bradfourie/edesign_344/README.md

# E344
I Bradley Fourie, student number 20795629 I declare
that the entirety of the work contained here is my own work towards completing E344 at Stellenbosch
Univeristy, and that I am the sole author thereof. I understand that copying someone else’s work is
theft, and that doing so may lead to disciplanary action against me.
