bradfourie/edesign_344/Reports/Fourie_20795629_A3/App-A.tex

     \chapter{Appendix A: GitHub activity heatmap}

     \begin{figure}[!htb]
     \centering
     	\fbox{}
	\label{fig:github}
	\end{figure}
