bradfourie/edesign_344/Reports/Fourie_20795629_A3/App-D.tex

\chapter{Appendix D: Signal conditioning calibration}

\begin{table} [h!]
        \centering
        \footnotesize
        \caption{Voltage transducer calibration results.}
             \begin{tabular}{C{2cm} C{2cm} C{2cm} C{2cm} }
           Emulated level & Applied input & Analogue output & Deduced input  \\
           ($V_{peak}$)   & ($V_{peak}$)   & ($V_{peak}$)   & ($V_{peak}$)        \\
           \hline
            10      & 1.34 & 1.33 & 9.95 \\
            15      & 2.06 & 2.00 & 14.62 \\
            20      & 2.77 & 2.69 & 19.41 \\
            25      & 3.49 & 3.37 & 24.15 \\
            30      & 4.21 & 4.05 & 28.88\\
          \hline
        \end{tabular}
     \label{tab:voltagetransducercalibrated}
\end{table}

\begin{table} [h!]
        \centering
        \footnotesize
        \caption{Current transducer calibration results.}
           \begin{tabular}{C{2cm} C{2cm} C{2cm} C{2cm} }
            Emulated level     & Applied input & Analogue output & Deduced input  \\
            ($mA_{peak}$) & ($V_{peak}$)   & ($V_{peak}$)   & ($mA_{peak}$)       \\
           \hline
             5.33  & 0.108 & 0.099 & 7.59 \\
             9.09  & 0.146 & 0.202 & 10.26 \\
             16.67 & 0.242 & 0.202 & 14.20 \\
             29.89 & 0.425 & 0.396 & 27.84\\
          \hline
        \end{tabular}
     \label{tab:currenttransducercalibrated}
\end{table}

\begin{table} [h!]
        \centering
        \scriptsize
        \caption{Phase shift transducer calibration results.}
            \begin{tabular}{C{2cm} C{2cm} C{2cm} C{2cm} }
            Emulated level     & Applied input & Analogue output & Deduced input  \\
            ($^o$)       & ($V_{peak}$)   & ($V_{peak}$)     & ($^o$) \\
            \hline
            0        & 0      & 0.072 & 2.592 \\
            6.48     & 0.180  & 0.240 & 8.62 \\
            26.88    & 1.08   & 0.832 & 29.83 \\
          \hline
        \end{tabular}
     \label{tab:phasetransducercalibrated}
\end{table}
