bradfourie/edesign_344/Reports/Fourie_20795629_A3/App-E.tex

\chapter{Appendix D: System schematic}

\begin{figure}[h]
  \centering
 \footnotesize
        
    		    \caption{Full system schematic.} \label{fig:full_circuit_diagram}
 \end{figure}
