bradfourie/edesign_344/Reports/Fourie_20795629_A3/E344Ass3Template.pdf

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

# Declaration

By submitting this report electronically, I declare that the entirety of the work contained therein is my own, original work, that I am the sole author thereof (save to the extent explicitly otherwise stated), that reproduction and publication thereof by Stellenbosch University will not infringe any third party rights and that I have not previously in its entirety or in part submitted it for obtaining any qualifcation.

**** Put your signature here and remove this line ****

Signature: |
E. Stewdent
Date: |

i

# Contents

Declaration | i
Contents | ii
List of Figures | iv
List of Tables | v
Nomenclature | vi
1 System design | 1
2 Power conversion | 2
3 Signal conditioning | 6
4 Over-current protection | 12

ii

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

# List of Figures

1.1 | System diagram | | 1
2.1 | Power conversion circuit diagram | | 2
2.2 | I am the short caption that appears in the List of Figures | | 4
2.3 | Implementation of the power conversion circuitry | | 5
3.1 | Voltage transducer circuit diagram | | 6
3.2 | Voltage transducer results. (a) No load simulated. (b) No load measured.
| (c) Mid-sized load simulated. (d) Mid-sized load measured. (c) | | 7
3.3 | Current transducer circuit diagram | | 8
3.4 | Current transducer results. (a) No load simulated. (b) No load measured.
| (c) Mid-sized load simulated. (d) Mid-sized load measured. (c) | | 9
3.5 | Phase-shift transducer circuit diagram | 10
3.6 | Phase-shift transducer results. (a) Resistive load simulated. (b) Resistive
| load measured. (c) Mid-sized capacitive load simulated. (d) Mid-sized ca-
pacitive load measured. (c) | 11
3.7 | Implementation of the transducers circuitry | 11
7.1 | Complete PCB | 15

iv

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

# Chapter 1

# System design

## 1.1 System overview

Here you insert a block diagram of your operational signal conditioning system. Try to explain what congiation you chose and why. There is no need to specify the capacitor and resistor values here, but you want to capture the higher-level functional arrangement you have opted for. The diagram ties together the other chapters in this report and helps the reader understand how you have connected the dierent funtional blocks together to produce the outputs. For example, a block could be Dierential aplier or level shifting op-amps or the like. Fig. 1.1 as an example that is completely irrelevant and just holds space for your beautiful system diagram.

18 VAC

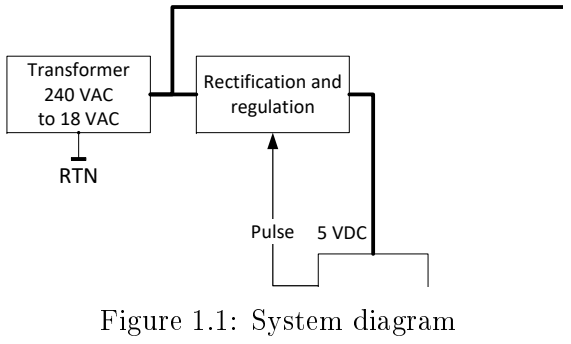
[picture p34: figure]
Rectification and regulation; Transformer 240 VAC to 18 VAC; Pulse; 5 VDC; RTN; Figure 1.1: System diagram

1

# Chapter 2

# Power conversion

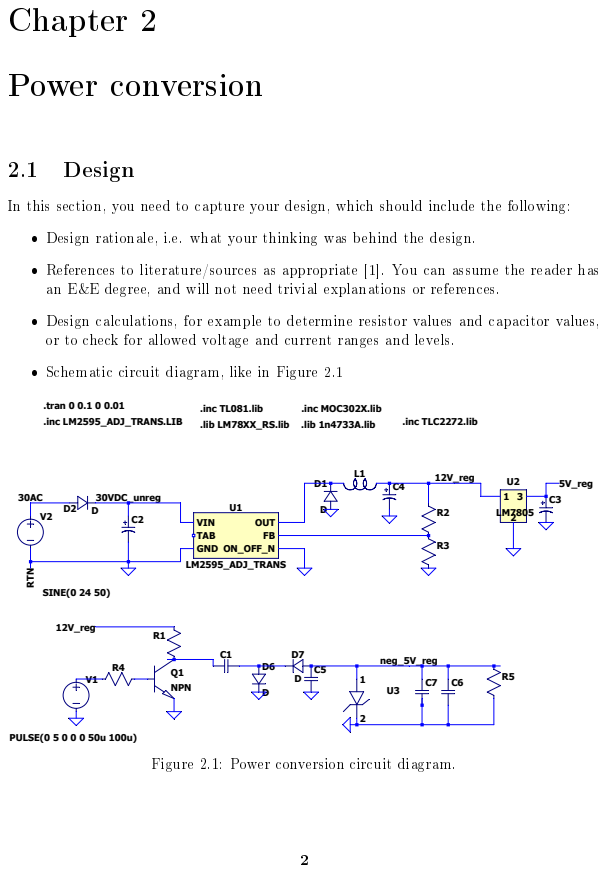
[picture p35: page 9]

In this section, you need to capture your design, which should include the following:

an E&E degree, and will not need trivial explanations or references.

or to check for allowed voltage and current ranges and levels.

.lib LM78XX_RS.lib .lib 1n4733A.lib

Figure 2.1: Power conversion circuit diagram.

CHAPTER 2. POWER CONVERSION | 3

## 2.2 Simulation

In this section, you want to demonstrate, by means of referring to simulation results, using the designed circuit, how your circuit is expected to behave. Present and report on your simulated results in Figures 2.2a, 2.2c and 2.2e Be absolutely sure that the text and information in your report are readable.

## 2.3 Measurements

In this secion, you must present and report on your measured results similar to Figures 2.2b, 2.2d and 2.2f - you can use a photo or screenshot of the scope, as long as I can zoom in to see the necessary detail.

## 2.4 Summary and implementation

State whether your design performs as expected. Give a snapshot of the relevant part of your circuit in Figure 2.3.

CHAPTER 2. POWER CONVERSION | 4

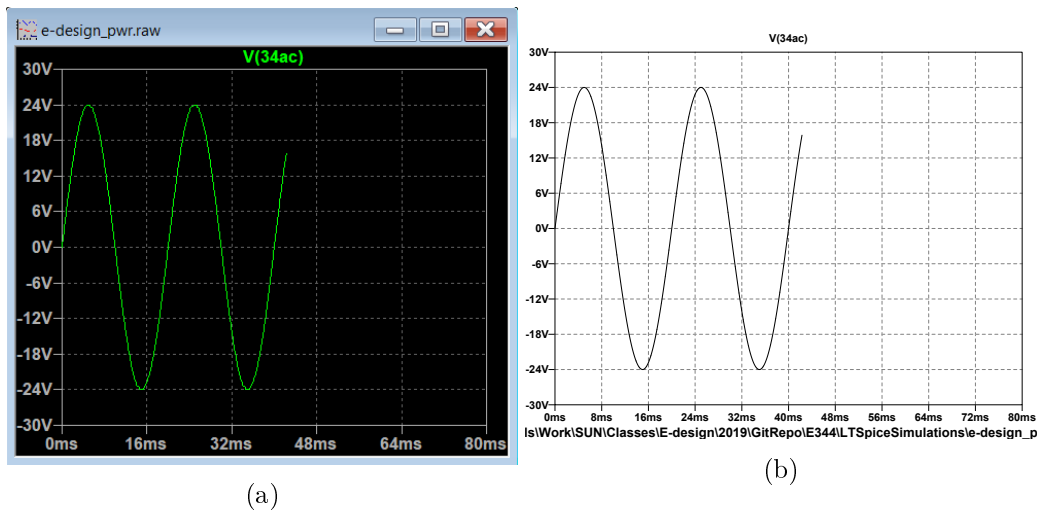
[picture p36: figure]
ls\Work\SUN\Classes\E-design\2019\GitRepo\E344\LTSpiceSimulations\e-design_p (b)
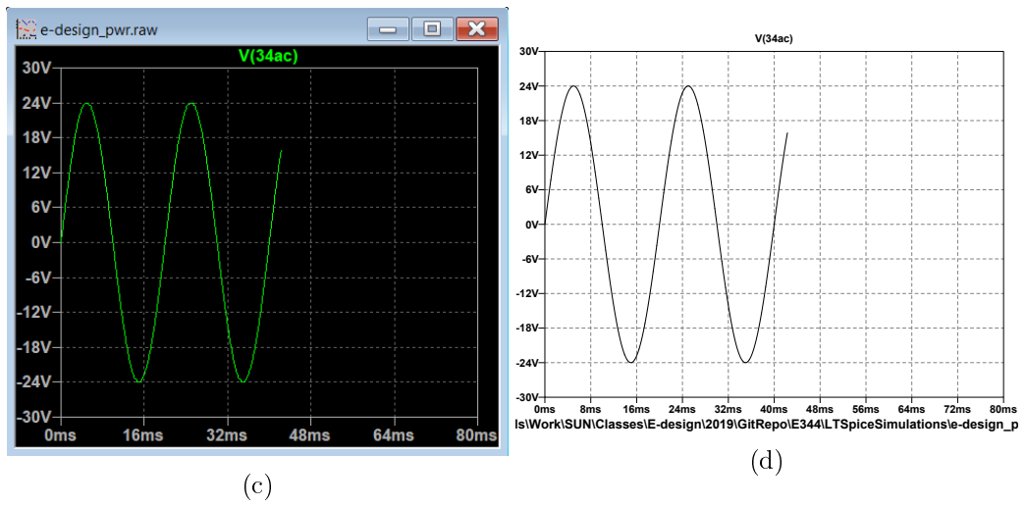
[picture p37: figure]
ls\Work\SUN\Classes\E-design\2019\GitRepo\E344\LTSpiceSimulations\e-design_p (d)
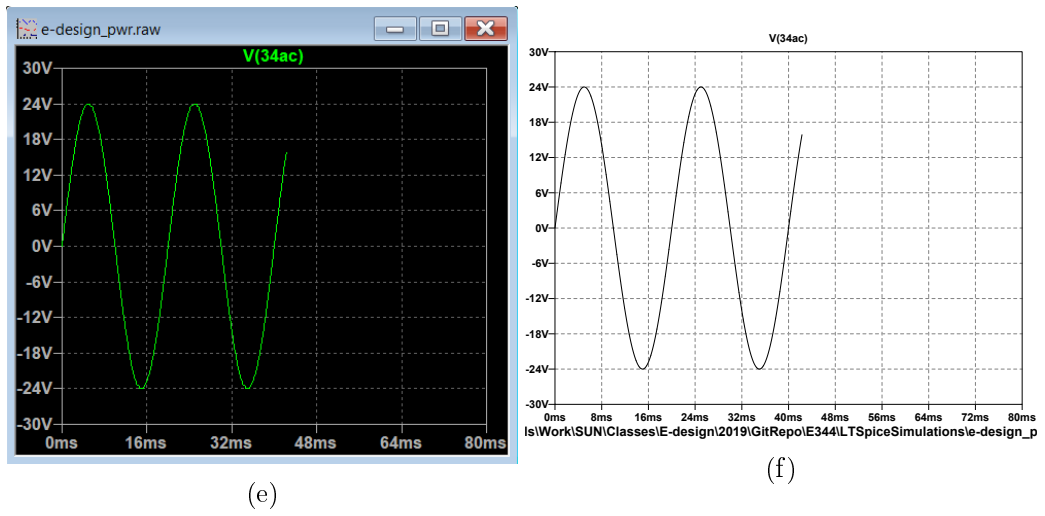
[picture p38: figure]
ls\Work\SUN\Classes\E-design\2019\GitRepo\E344\LTSpiceSimulations\e-design_p (f)

Figure 2.2: Power conditioning: (a) Simulation of the rectication showing the input AC and the rectied signal. (b) Measurement of the rectication showing the input AC and the rectied signal. (c) Simualtion output of the voltage rail levels. (d) Measurement of the output voltage rails levels. (e) Simulation output of the noise on the voltage rails. (f) Measurement of the noise on the voltage rails.

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

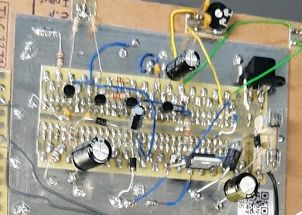
[picture p39: figure]

# Chapter 3

# Signal conditioning

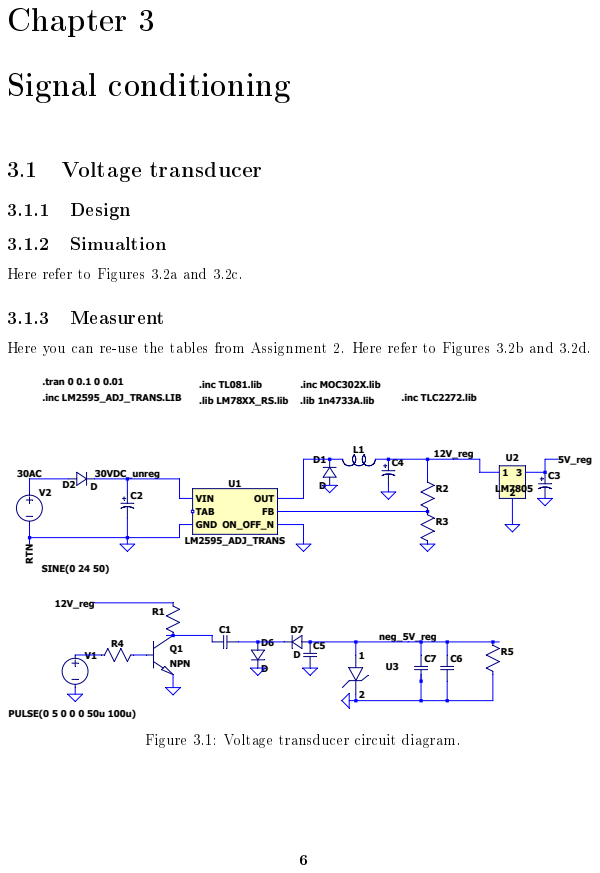
[picture p40: page 13]

Here refer to Figures 3.2a and 3.2c.

Here you can re-use the tables from Assignment 2. Here refer to Figures 3.2b and 3.2d.

.lib LM78XX_RS.lib .lib 1n4733A.lib

Figure 3.1: Voltage transducer circuit diagram.

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

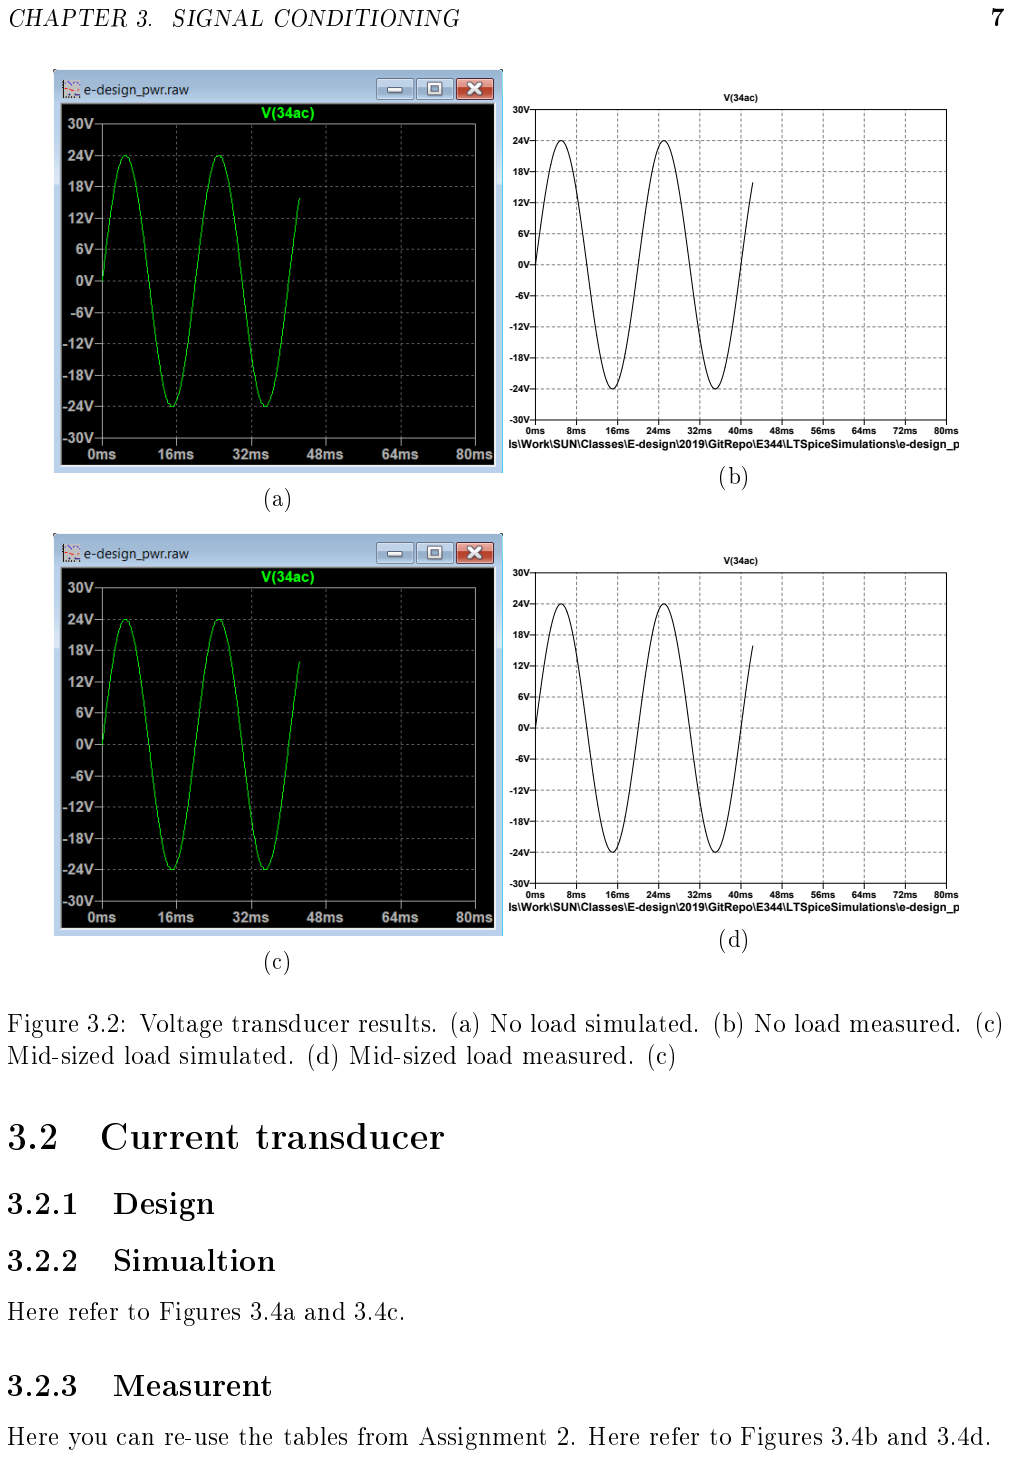
[picture p41: page 14]

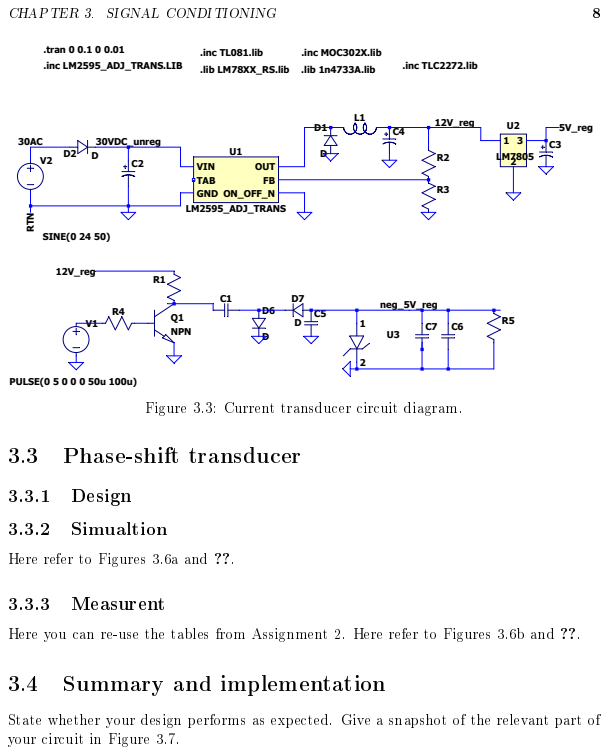
[picture p42: page 15]

.lib LM78XX_RS.lib .lib 1n4733A.lib

Figure 3.3: Current transducer circuit diagram.

Here refer to Figures 3.6a and ??.

Here you can re-use the tables from Assignment 2. Here refer to Figures 3.6b and ??.

State whether your design performs as expected. Give a snapshot of the relevant part of
your circuit in Figure 3.7.

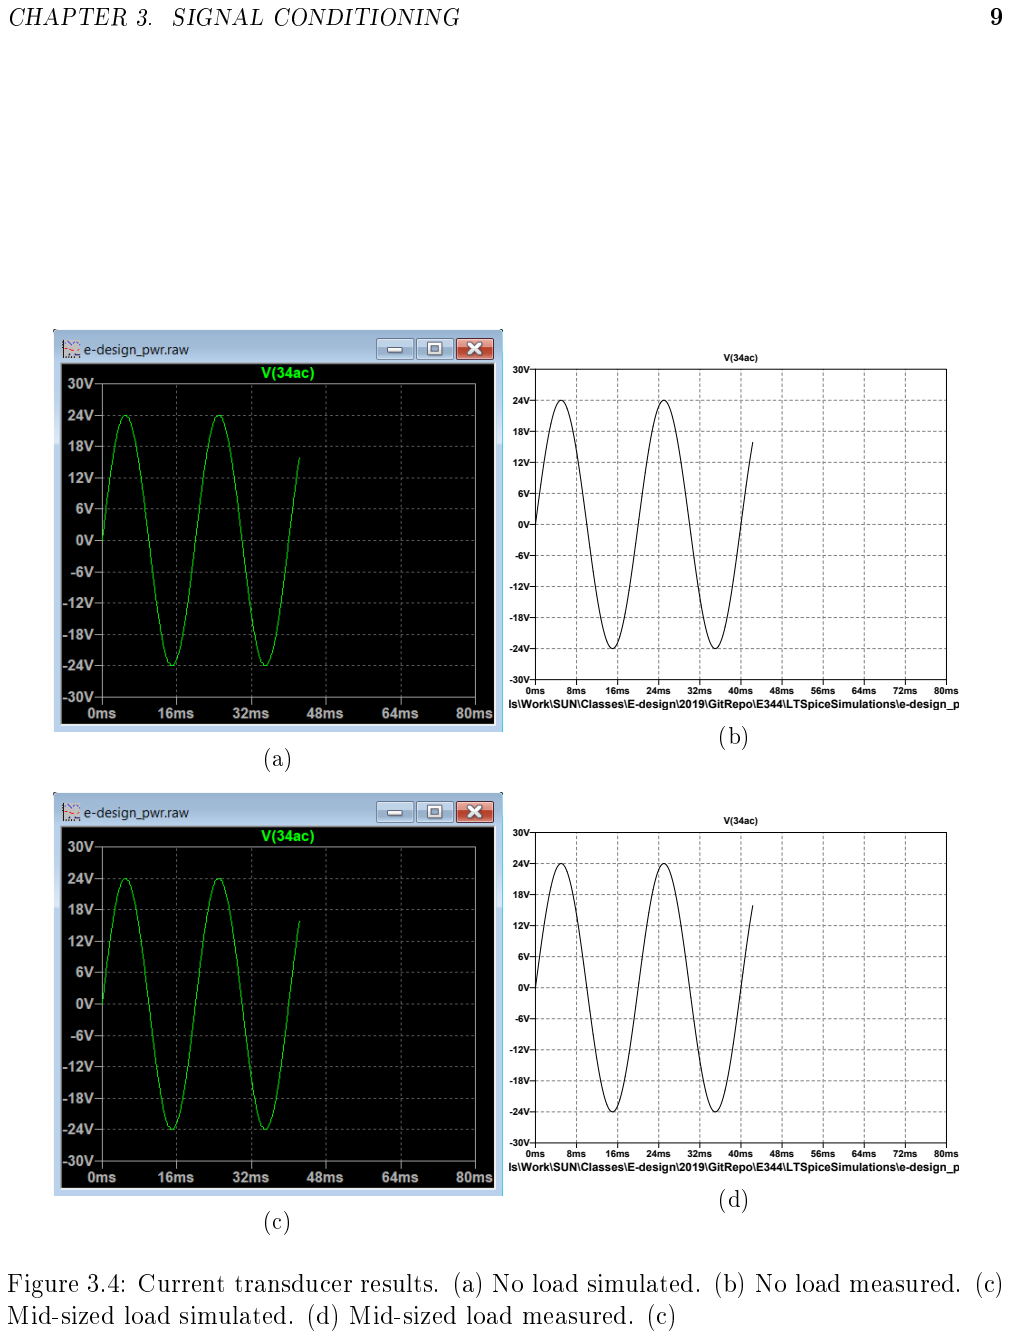
[picture p43: page 16]
CHAPTER 3. SIGNAL CONDITIONING

ls\Work\SUN\Classes\E-design\2019\GitRepo\E344\LTSpiceSimulations\e-design_p

Figure 3.4: Current transducer results. (a) No load simulated. (b) No load measured. (c)
Mid-sized load simulated. (d) Mid-sized load measured. (c)

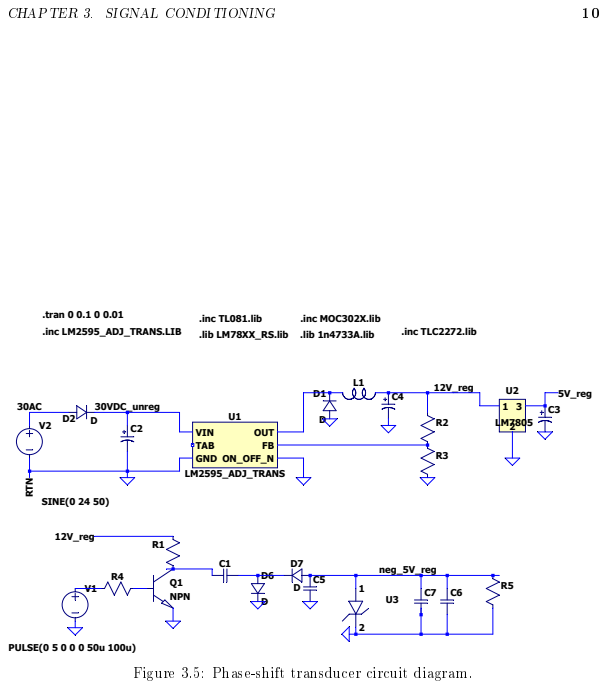
[picture p44: page 17]

.lib LM78XX_RS.lib .lib 1n4733A.lib

Figure 3.5: Phase-shift transducer circuit diagram.

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

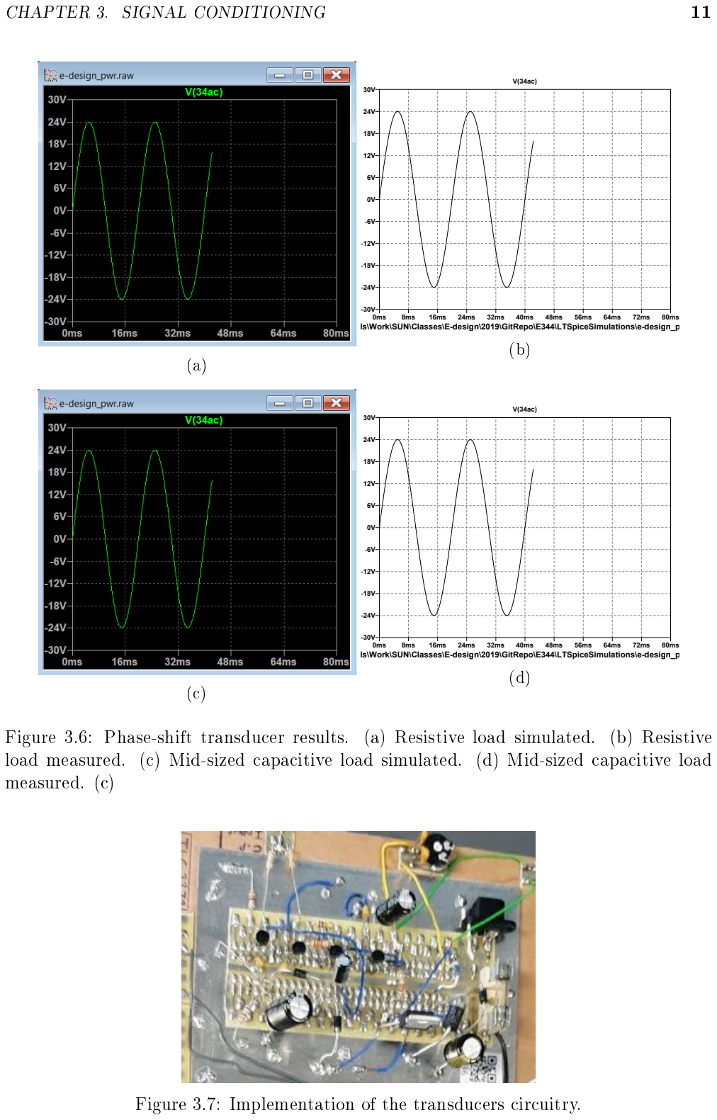
[picture p45: page 18]

# Chapter 4

# Over-current protection

Follow the same format as the previous chapters - circuit diagram, and then simulated and measured results.

## 4.1 Design

## 4.2 Simulation

## 4.3 Measurements

12

# Chapter 5

# Reporting

## 5.1 Design

Here give a ow diagram or psuedocode listing of your Arduino code and a ow diagram or psuedocode of your Python code. Give a circuit diagram and/or description of how you connected the grounds vs voltages and how you protected the interface to the Beetle agains over-voltage conditions. Maybe show a screengrab of the scope measuring the UART line.

## 5.2 Results

Show some screen grabs of your GUI.

13

# Chapter 6

# Extra functionality

Be very clear about what the extra functionality is, and convince the reader.

14

# Chapter 7

# System and conclusion

## 7.1 System

Photo of your student card next to your PCB. Indicate the functional blocks of your PBC here (preferably by overlaying blocks using something like powerpoint.

## 7.2 Lessons learned

Write down at least ve of the most important things you have learned or lessons you acquired from E344.

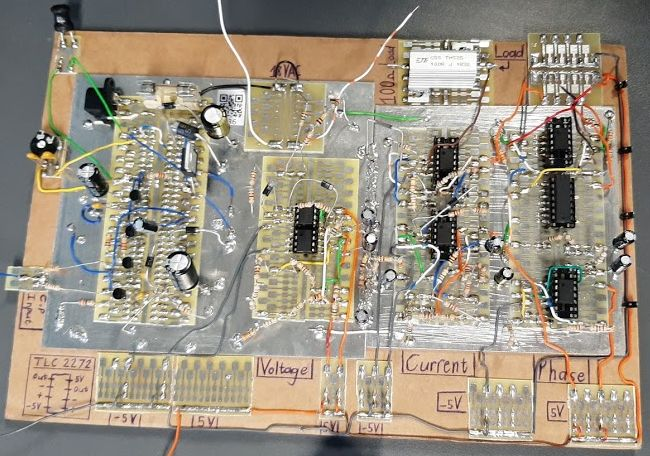
[picture p46: figure]

Figure 7.1: Complete PCB.

15

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

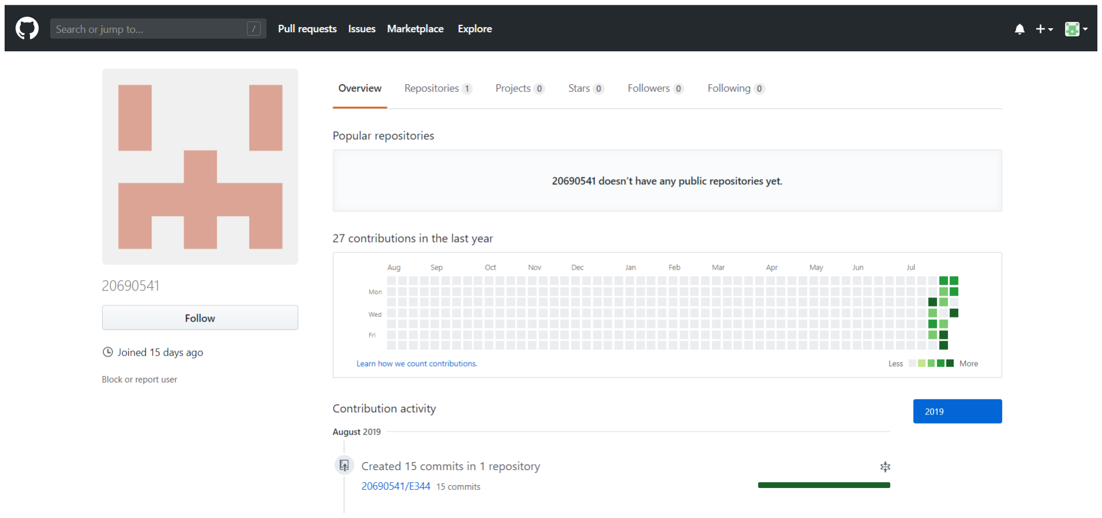
[picture p47: figure]

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
