bradfourie/edesign_344/Reports/20795629_A2/E344Ass2Template.pdf

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

# Declaration

By submitting this report electronically, I declare that the entirety of the work contained therein is my own, original work, that I am the sole author thereof (save to the extent explicitly otherwise stated), that reproduction and publication thereof by Stellenbosch University will not infringe any third party rights and that I have not previously in its entirety or in part submitted it for obtaining any qualifcation.

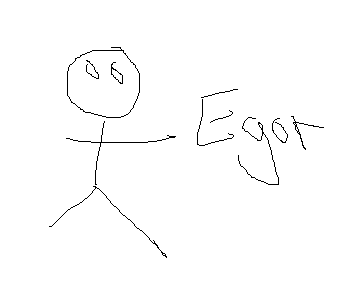
[picture p48: figure]

Signature: |
E. Stewdent
Date: |

i

# Contents

Declaration | i
Contents | ii
List of Figures | iv
List of Tables | v
Nomenclature | vi
1 Signal conditioning system design | 1
2 Voltage peak transducer | 2
3 Current peak transducer | 5
4 Phase shift transducer | 6
5 System tests | 7

ii

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

# List of Figures

1.1 | System diagram | | 1
2.1 | I am the short caption for the list of gures | | 3

iv

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

# Chapter 1

# Signal conditioning system design

## 1.1 System overview

Here you insert a block diagram of your operational signal conditioning system. There is no need to specify the capacitor and resistor values here, but you want to capture the higher-level functional arrangement you have opted for. The diagram ties together the other chapters in this report and helps the reader understand how you have connected the dierent funtional blocks together to produce the outputs. For example, a block could be Dierential aplier or level shifting op-amps or the like. Fig. 1.1 as an example that is completely irrelevant and just holds space.

18 VAC

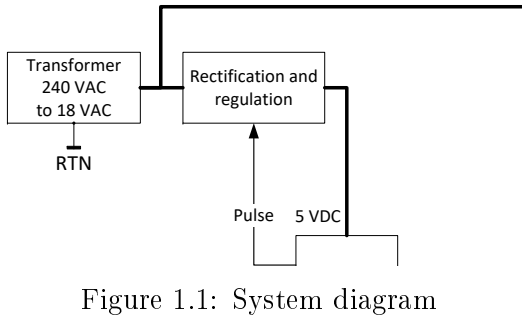
[picture p49: figure]
Rectification and regulation; Transformer 240 VAC to 18 VAC; Pulse; 5 VDC; RTN; Figure 1.1: System diagram

1

# Chapter 2

# Voltage peak transducer

## 2.1 Theory and releated work

In this section, you put a very short summary of infrormation you gatherered from literature (papers, web sites, datasheets) that you used to do the design. Be sure to include the references, which you can add in the References.tex le.
Some examples of how to cite (all in References.bib): It was stated by [1] that ... . Subsequently, he changed his mind and said in [2] that ... . While [3] claims it to be ... .

## 2.2 Design

In this section, you need to capture your design, which should include the following:

| Design rationale, i.e. what your thinking was behind the design
| Design calculations, for example to determine resistor values and capacitor values, or to check for allowed voltage and current ranges and levels.
| Circuit diagram.

## 2.3 Simulation

In this section, you want to demonstrate, by means of simulation results, using the designed circuit, what your circuit is expected to behave. An example is the gure shown in Figure 2.1 or Subgure 2.1a. Be absolutely sure that the text and information in your report are readable.

2

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

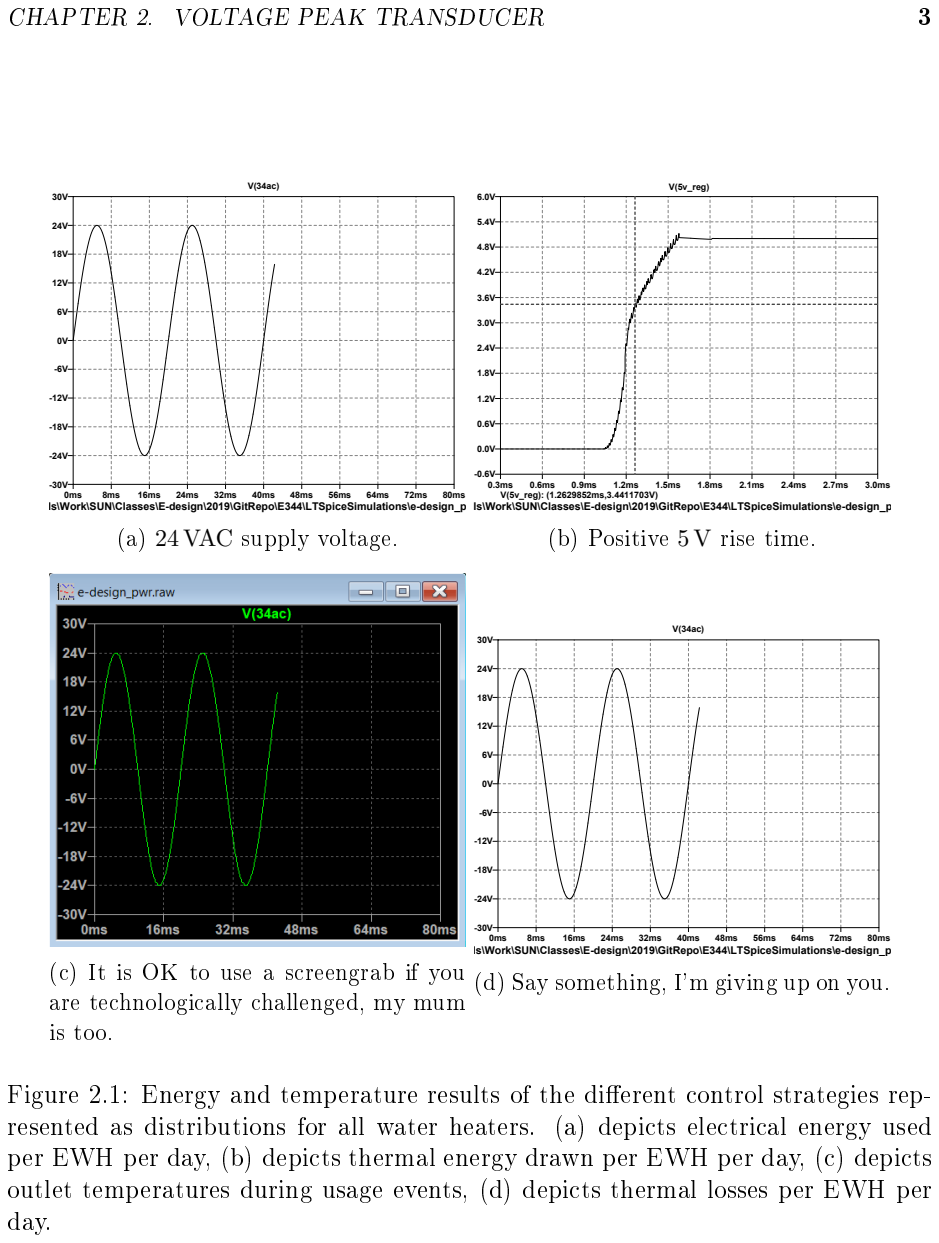
[picture p50: page 10]

CHAPTER 2. VOLTAGE PEAK TRANSDUCER | 4

## 2.4 Measurements

In this secion, you must present your measured results. You can use screengrabs or photos of the oscilloscope, or download the CSVs and plot them as PDFs using Matlab, Excel or similar.

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

# Chapter 5

# System tests

Here you include an image of your PCB (showing your barcoded ID) and any system-level tests you deem appropriate. For example, the total current drawn by the opamp circuitry.

7

# References

[1] Booysen, M.J., Andersen, S.J. and Zeeman, A.S.: Informal public transport in Sub-Saharan Africa as a vessel for novel Intelligent Transport Systems. In: 16th International IEEE Conference on Intelligent Transportation Systems (ITSC 2013), pp. 767772. Oct 2013. ISSN 2153-0009.
[2] Gerber, S., Rix, A.J. and Booysen, M.J.: Combining grid-tied PV and intelligent water heater control to reduce the energy costs at schools in South Africa. Energy for Sustainable Development, vol. 50, pp. 117 125, 2019. ISSN 0973-0826.
[3] BBC: How to make opamps amp op. 2018.

Available at: www.electronics-tutorials.ws

8

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
