bradfourie/edesign_344/Reports/Fourie_20795629_A3/Figures/PCB.pdf

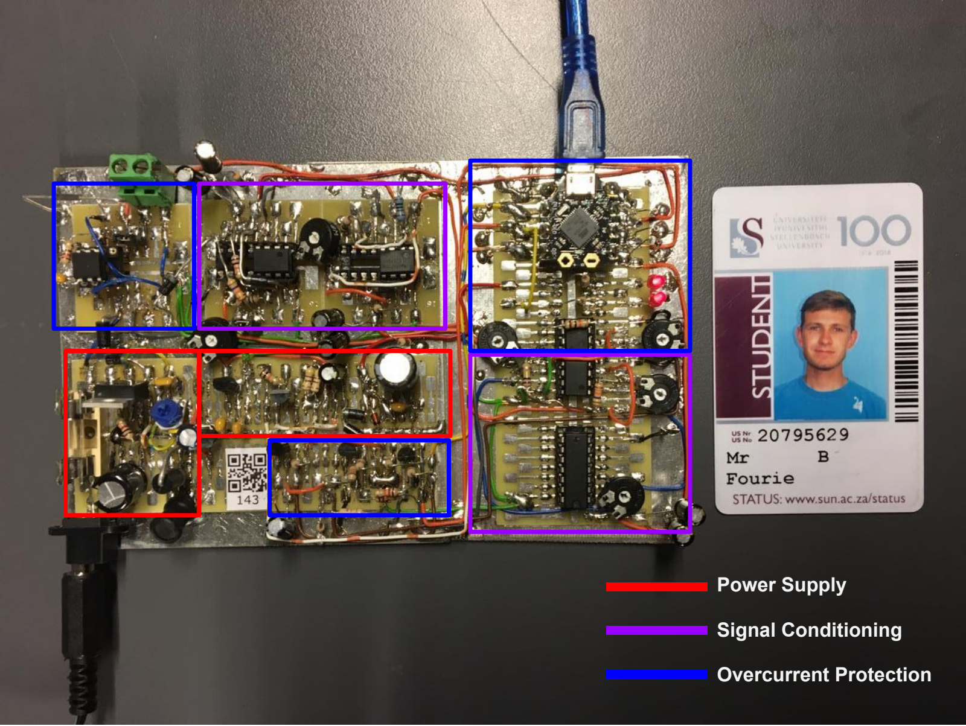
[picture p55: page 1]

Power Supply

Signal Conditioning

Overcurrent Protection
