bradfourie/edesign_344/Reports/Fourie_20795629_A3/Figures/pwr_simu_rails_pos.pdf

0ms | 4ms | 8ms | 12ms | 16ms | 20ms | 24ms | 28ms | 32ms | 36ms | 40ms

0.0V

0.5V

1.0V

1.5V

2.0V

2.5V

3.0V

3.5V

4.0V

4.5V

5.0V

5.5V

6.0V

V(5v)

## --- H:\BradsStuff\Edesign344\Assignment 1\Fourie_20795629_A1.raw ---
