bradfourie/edesign_344/Reports/Fourie_20795629_A3/Figures/python_code_flow.pdf

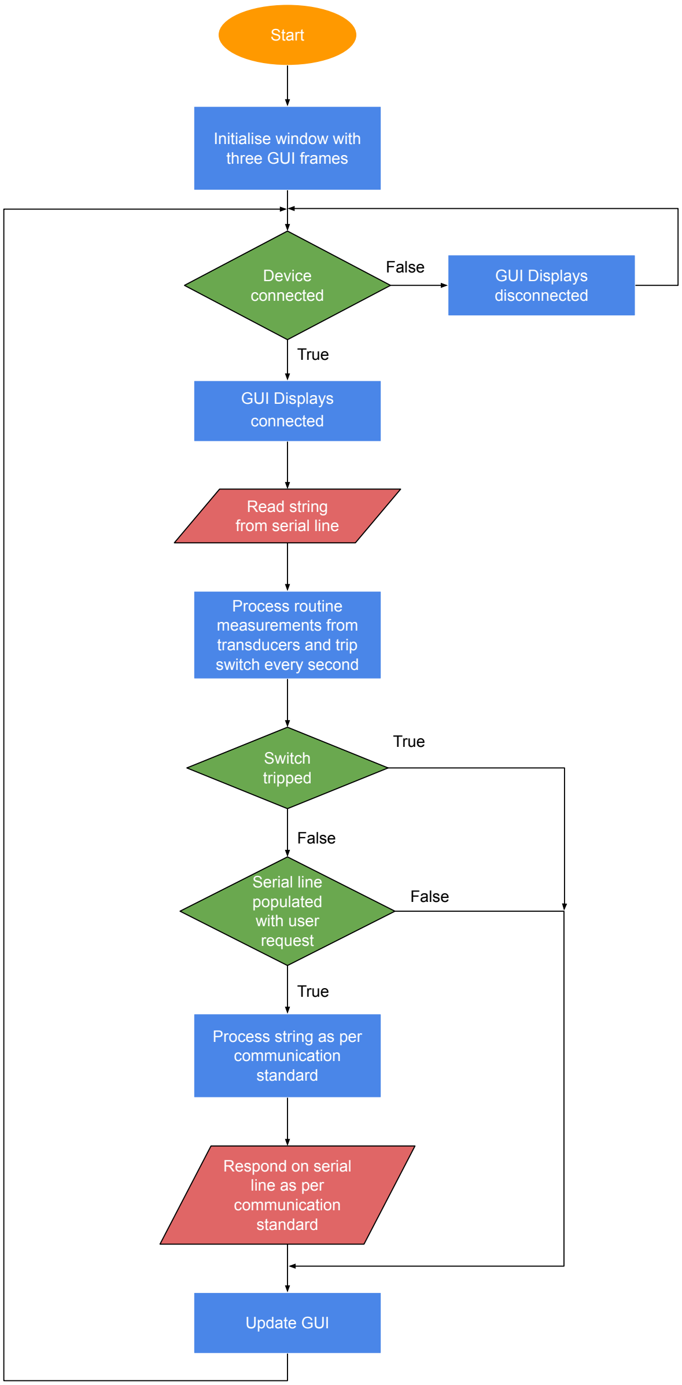
[picture p56: figure]
Start; Initialise window with three GUI frames; Device connected; GUI Displays; connected; GUI Displays disconnected; Serial line populated with user request; Process string as per communication standard; Process routine measurements from transducers and trip switch every second; Read string from serial line; Switch tripped; Update GUI; False; True; Respond on serial line as per communication standard
