bradfourie/edesign_344/Reports/Fourie_20795629_A3/Figures/reset_init_output.pdf

0ms | 20ms | 40ms | 60ms | 80ms | 100ms | 120ms | 140ms | 160ms | 180ms | 200ms

0.0V

0.5V

1.0V

1.5V

2.0V

2.5V

3.0V

3.5V

4.0V

4.5V

5.0V

5.5V

V(reset)

### --- H:\BradsStuff\Edesign344\Assignment 3\Draft1.raw ---
