bradfourie/edesign_344/Reports/Fourie_20795629_A2/Figures/phasetransducer1k22u.pdf

0ms | 5ms | 10ms | 15ms | 20ms | 25ms | 30ms | 35ms | 40ms | 45ms | 50ms | 55ms | 60ms | 65ms | 70ms | 75ms | 80ms | 85ms | 90ms | 95ms 100ms

-0.5V

0.0V

0.5V

1.0V

1.5V

2.0V

2.5V

3.0V

3.5V

4.0V

4.5V

5.0V

5.5V

V(pwm)

### --- K:\Assignment 2\Fourie_20795629_A2.raw ---
