bradfourie/edesign_344/Reports/Fourie_20795629_A3/Figures/reset_init_schem.pdf

.tran 0 1.5 0 800m uic

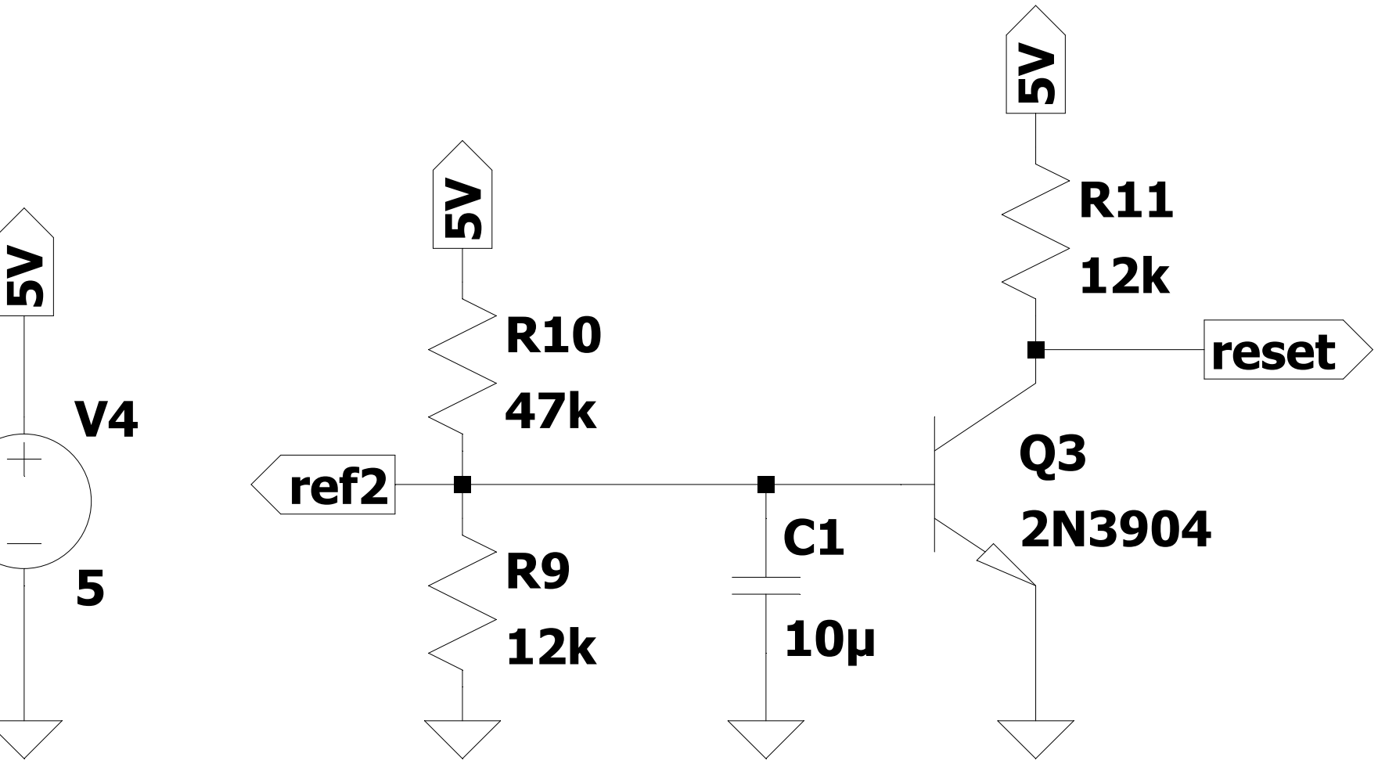
[picture p57: figure]
ref2; reset

--- H:\BradsStuff\Edesign344\Assignment 3\Draft1.asc ---
