bradfourie/edesign_344/Reports/Fourie_20795629_A1/App-A.tex

     \chapter{Appendix A: Social contract}
     \vspace{-15mm}
     \begin{figure}[!htb]
     \centering
     	\fbox{}
       \label{fig:social_contract}
	\end{figure}
