bradfourie/edesign_344/Reports/Fourie_20795629_A1/App-B.tex

     \chapter{Appendix B: Wiring safety check}
     \vspace{-15mm}
     \begin{figure}[!htb]
     \centering
     	\fbox{}
	\label{fig:plugSafety}
	\end{figure}
