bradfourie/edesign_344/Reports/Fourie_20795629_A1/App-C.tex

     \chapter{Appendix C: Screengrab of GitHub repo}
     \vspace{-15mm}
     \begin{figure}[!htb]
     \centering
     	\fbox{}
	\label{fig:github}
	\end{figure}
