bradfourie/edesign_344/Reports/Fourie_20795629_A1/Figures/rectifier24vplot.jpg

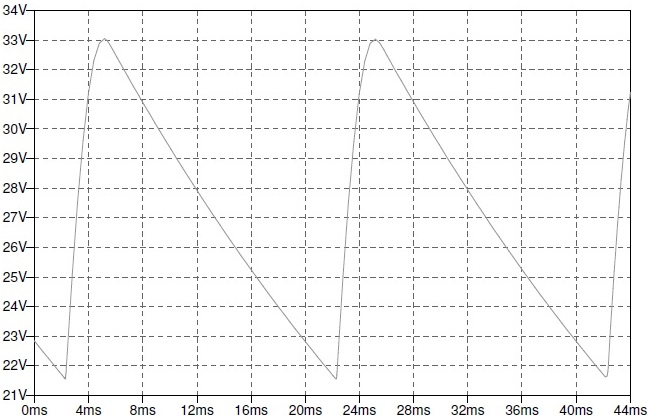
Reports/Fourie_20795629_A1/Figures/rectifier24vplot.jpg
