bradfourie/edesign_344/Reports/Fourie_20795629_A2/Figures/GitHub.png

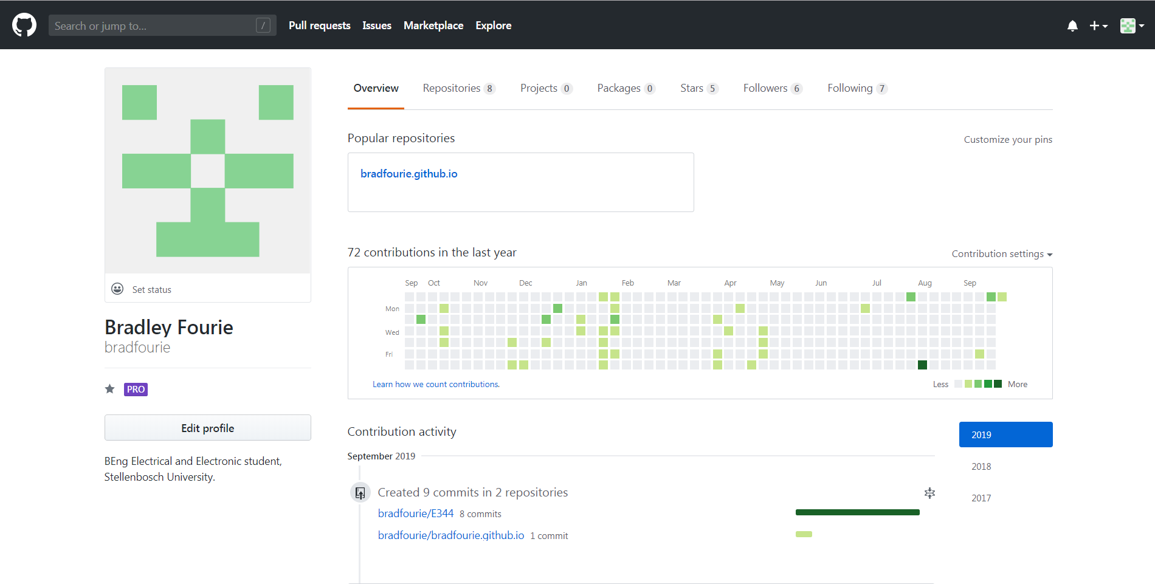
Reports/Fourie_20795629_A2/Figures/GitHub.png
