bradfourie/edesign_344/Reports/Fourie_20795629_A3/Figures/gui_trip.PNG

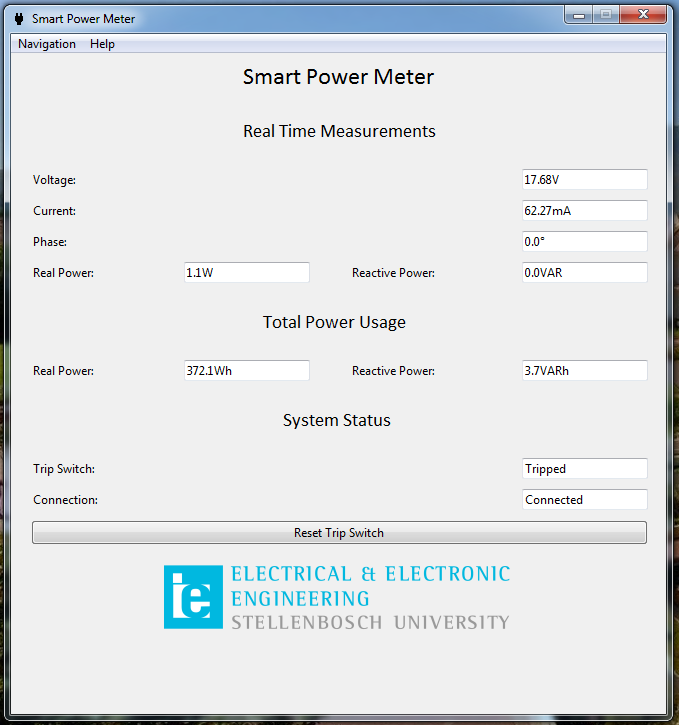
Reports/Fourie_20795629_A3/Figures/gui_trip.PNG
