bradfourie/edesign_344/Reports/Fourie_20795629_A3/nomenclature.tex

\chapter{Nomenclature}

\begin{Nomencl}
 \NomGroup{Variables}%-----------------------------------------------
   \item[$P$]
                      \UnitLine{Power}{W}
    \item[$I$]
                      \UnitLine{Current}{A}
    \item[$V$]
                      \UnitLine{Voltage}{V}
    \item[$R$]
                      \UnitLine{Resistance}{\Omega}
    \item[$F$]
                      \UnitLine{Capacitance}{F}
    \item[$H$]
                      \UnitLine{Inductance}{H}
    \item[$f$]
                      \UnitLine{Frequency}{Hz}
    \item[$\eta$]
                      \UnitLine{Efficiency}{\%}
                      
 \NomGroup{Abbreviations}%-----------------------------------------------
   \item[AC]    Alternating Current
   \item[ADC]   Analogue To Digital Converter
   \item[DC]    Direct Current
   \item[GUI]   Graphical User Interface
   \item[PWM]   Pulse Width Modulated
   \item[RC]    Resistor-Capacitor
   \item[RMS]   Root Mean Square
   \item[SMPS]  Switch Mode Power Supply
   \item[SR]    Set-Reset
   \item[TVS]   Transient Voltage Suppression
   \item[UART]  Universal Asynchronous Receiver\textbackslash Transmitter
   \item[XOR]   Exclusive Or
\end{Nomencl}

\endinput
