bradfourie/edesign_344/Reports/Fourie_20795629_A2/Figures/measurement_diagram.pdf

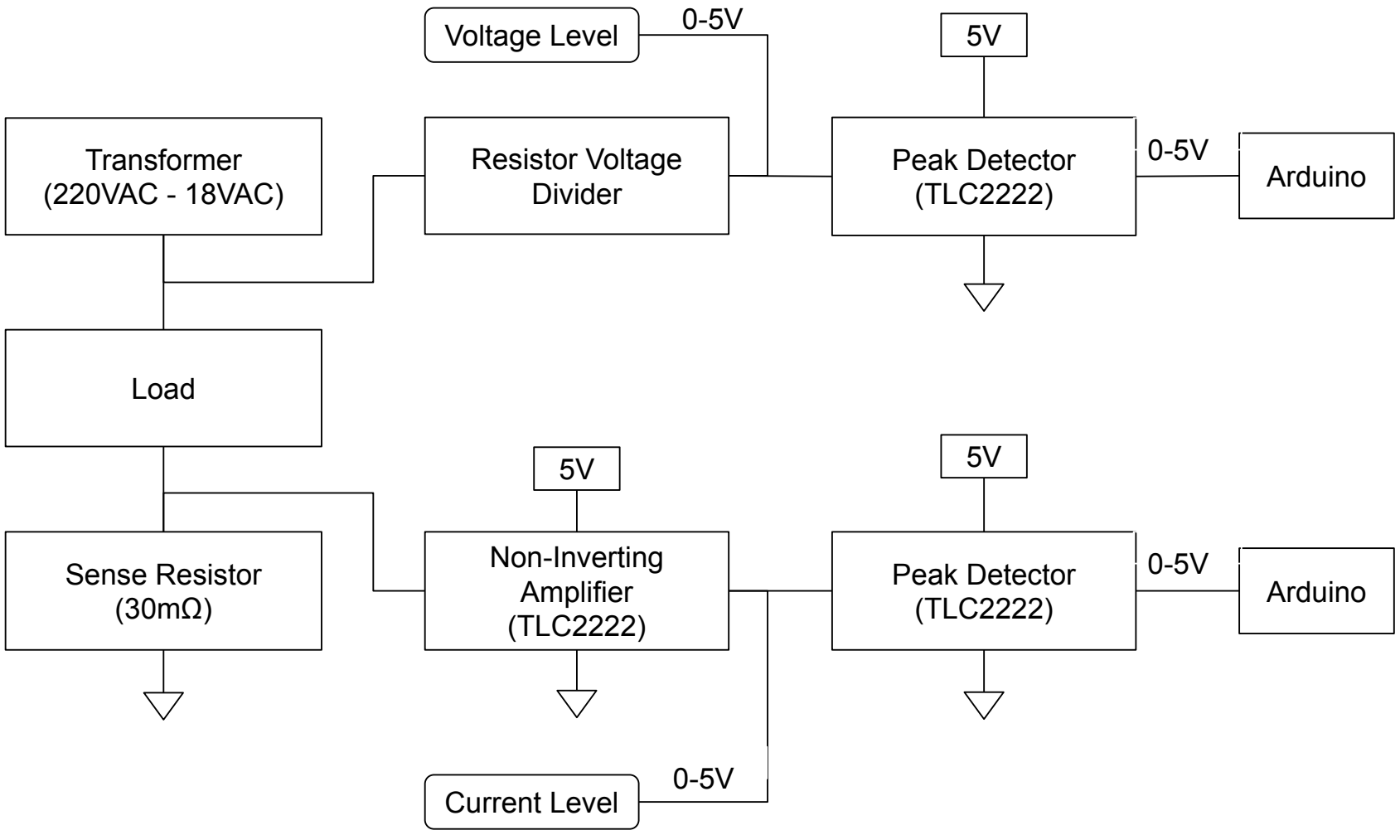
[picture p66: figure]
Transformer (220VAC - 18VAC); Non-Inverting Amplifier (TLC2222); Load; Sense Resistor (30mΩ); Resistor Voltage Divider; Peak Detector (TLC2222); Arduino; Current Level; Voltage Level
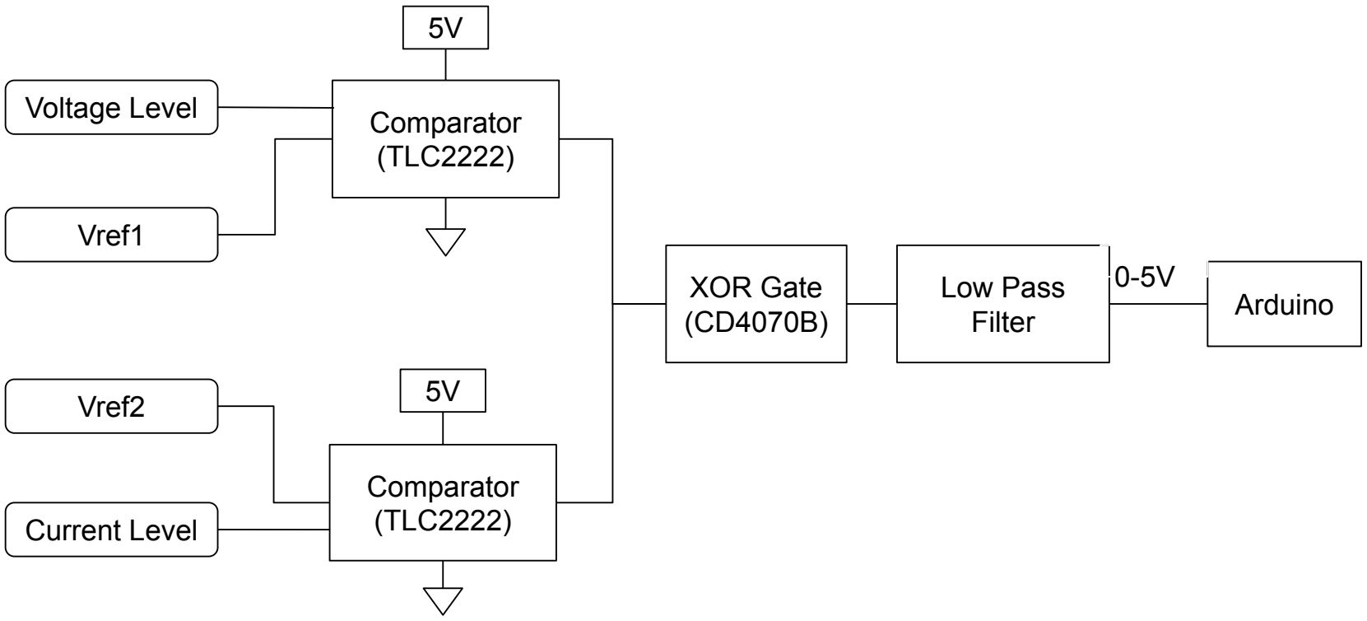
[picture p67: figure]
Comparator (TLC2222); XOR Gate (CD4070B); Current Level; Voltage Level; Vref1; Low Pass; Filter; Arduino; Vref2
