bradfourie/edesign_344/Reports/20795629_A2/Figures/measurement_diagram.pdf

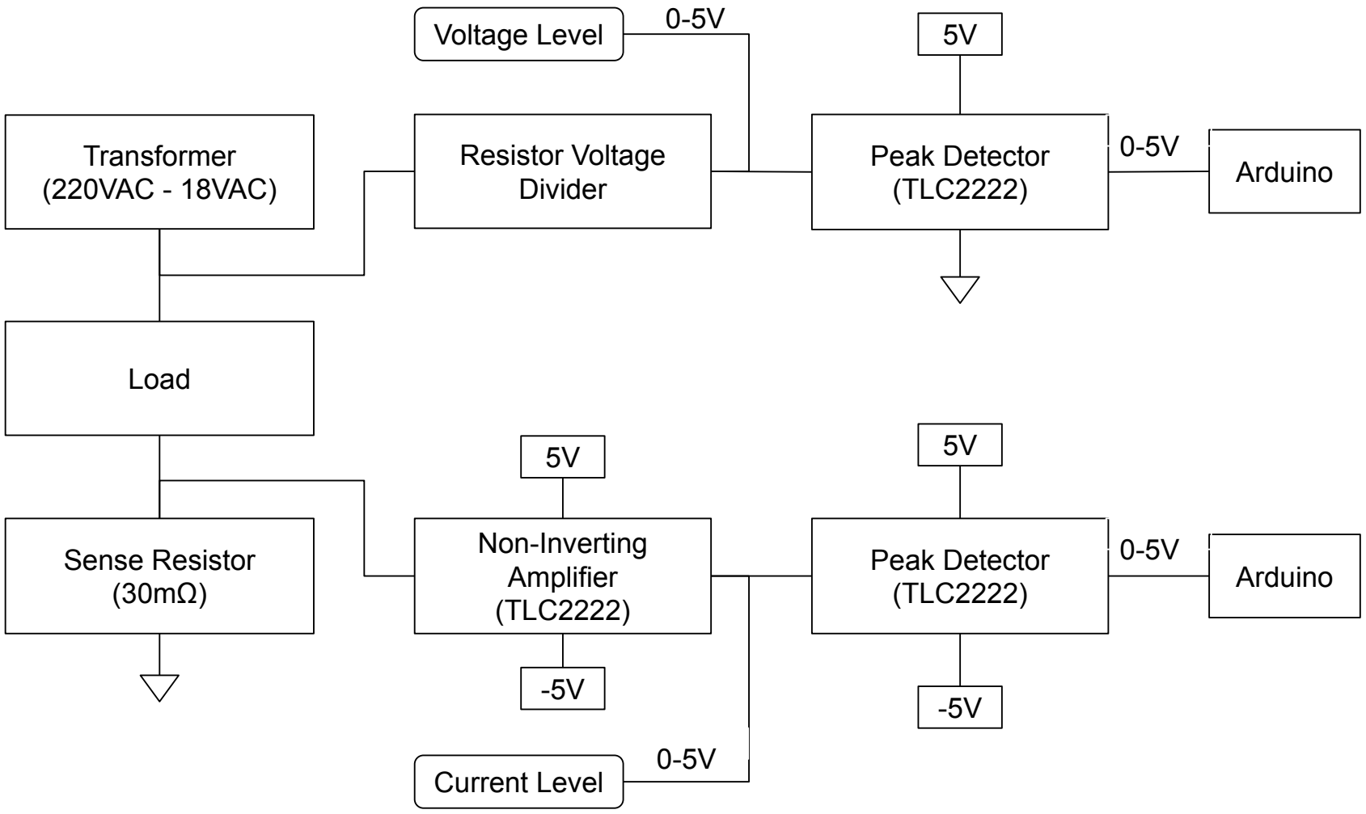
[picture p68: figure]
Transformer (220VAC - 18VAC); Non-Inverting Amplifier (TLC2222); Load; Sense Resistor (30mΩ); Resistor Voltage Divider; Peak Detector (TLC2222); Arduino; Current Level; Voltage Level
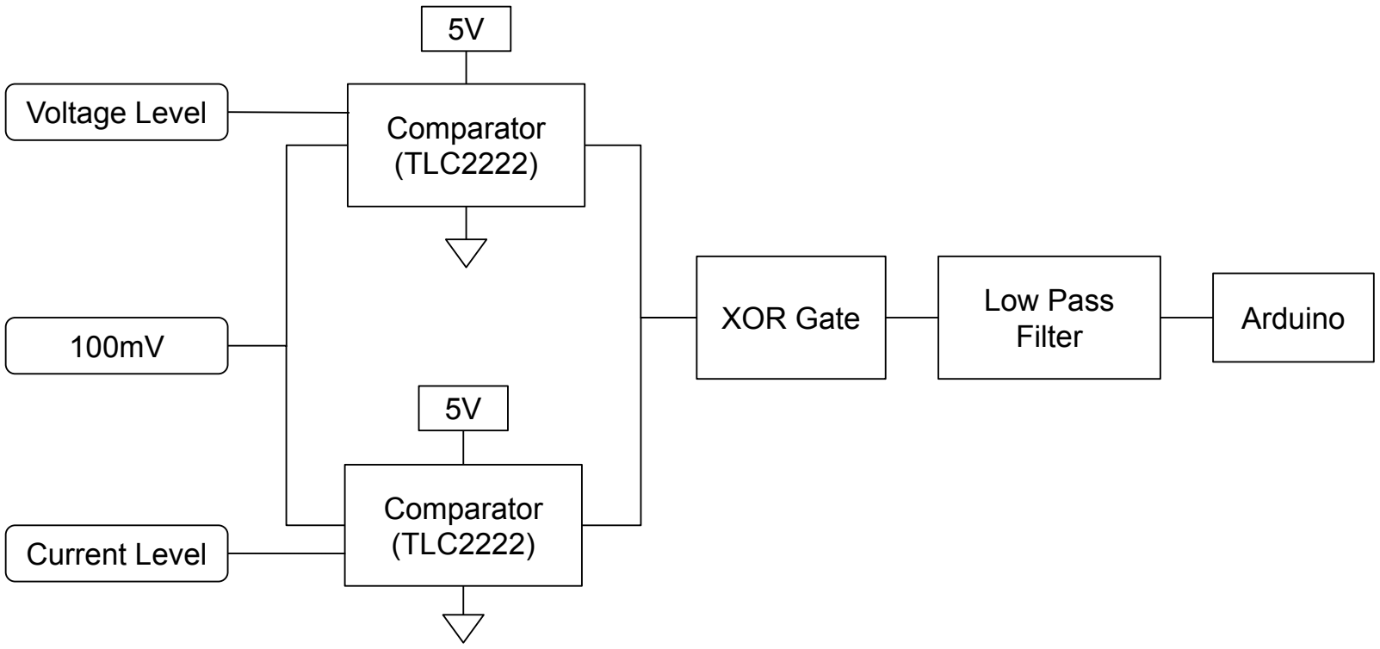
[picture p69: figure]
Comparator (TLC2222); XOR Gate; Current Level; Voltage Level; Low Pass; Filter; Arduino
