bradfourie/edesign_344/Reports/Fourie_20795629_A3/Figures/arduino_code_flow.pdf

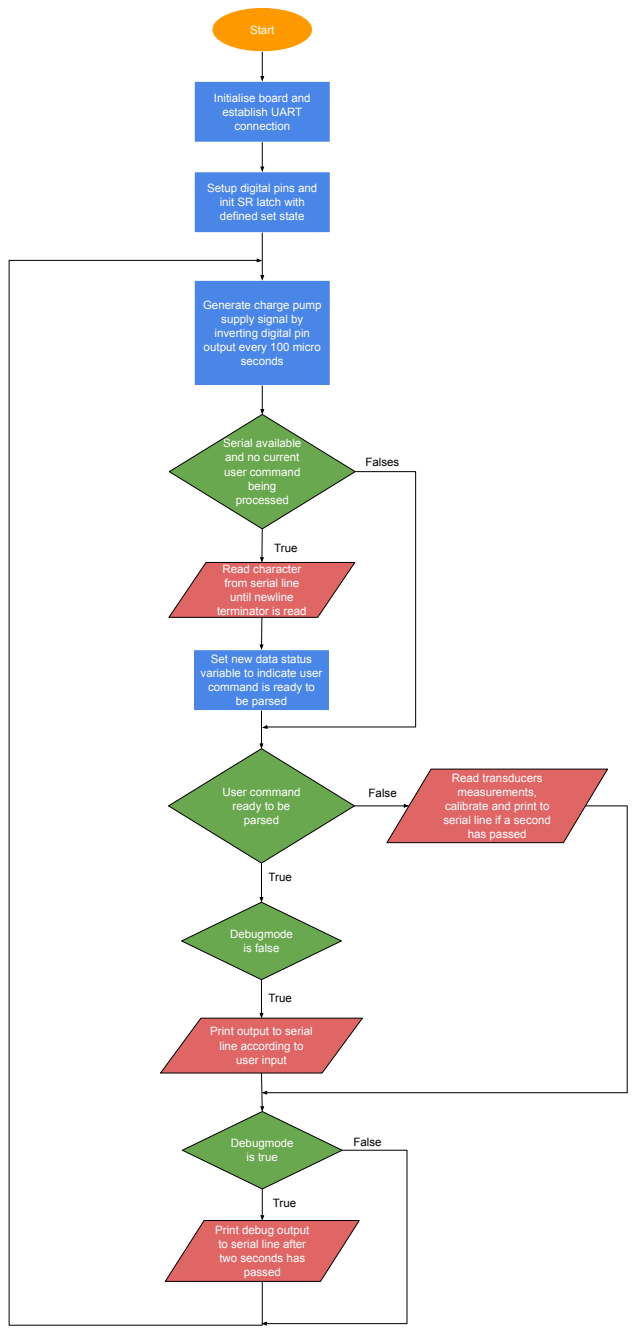
[picture p70: page 1]
Start; True; Falses; False; Debugmode is false; seconds; Debugmode is true

Initialise board and
establish UART
connection

Setup digital pins and
init SR latch with
defined set state

Generate charge pump
supply signal by
inverting digital pin
output every 100 micro

Serial available
and no current
user command
being
processed

Read character
from serial line
until newline
terminator is read

Set new data status
variable to indicate user
command is ready to
be parsed

Read transducers
measurements,
calibrate and print to
serial line if a second
has passed

User command
ready to be
parsed

Print output to serial
line according to
user input

Print debug output
to serial line after
two seconds has
passed
