bradfourie/edesign_344/Reports/Fourie_20795629_A3/Figures/system_diagram.pdf

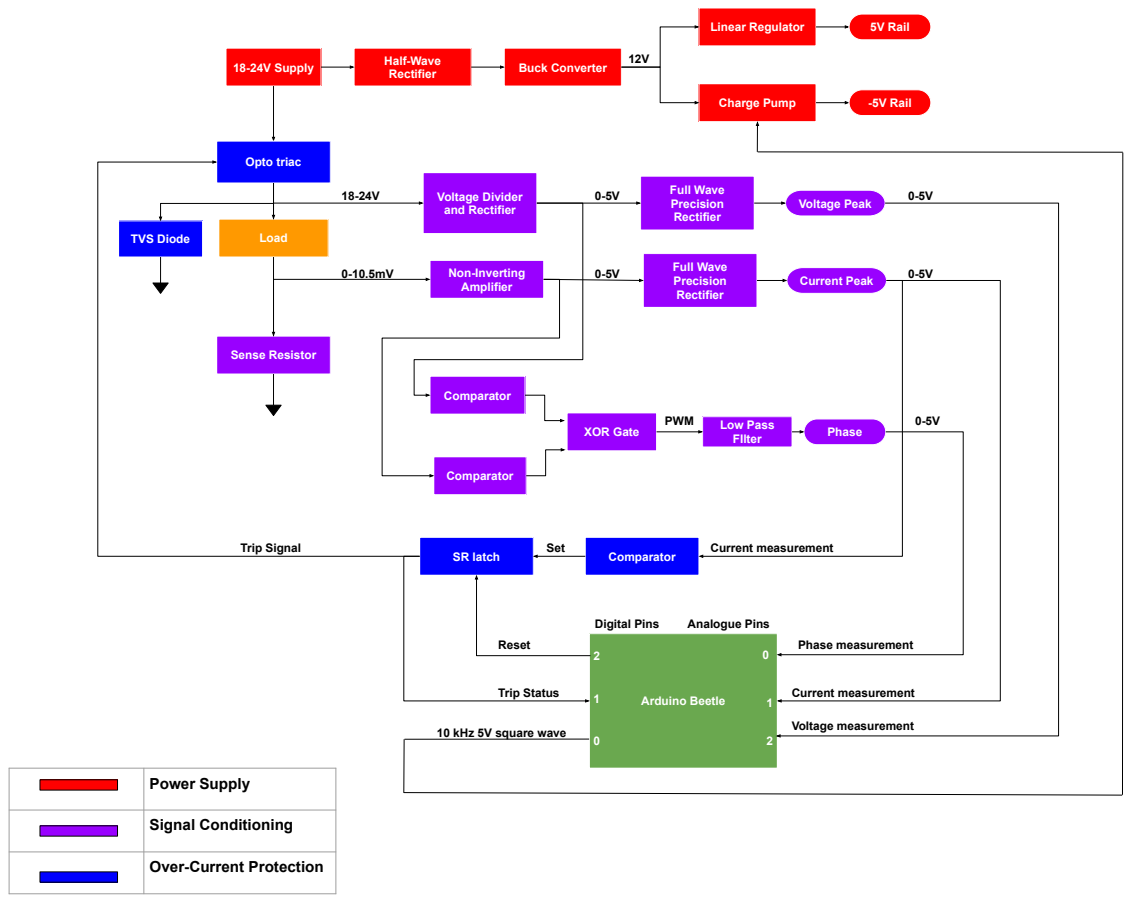
[picture p71: page 1]
Load; 18-24V Supply; Half-Wave; Rectifier; Buck Converter; Linear Regulator; Charge Pump; Sense Resistor; Arduino Beetle; Voltage Divider and Rectifier; Full Wave Precision Rectifier; Non-Inverting Amplifier; XOR Gate; Low Pass; FIlter; SR latch; Comparator; Opto triac; 5V Rail; -5V Rail; Voltage Peak; Current Peak; Phase; Digital Pins; Analogue Pins; Trip Signal; Reset; Set; Trip Status; 10 kHz 5V square wave; Voltage measurement; Current measurement; Phase measurement; PWM; TVS Diode

Power Supply

Signal Conditioning

Over-Current Protection
