bradfourie/edesign_344/Reports/Fourie_20795629_A3/Figures/itrans_circuit_diagram.pdf

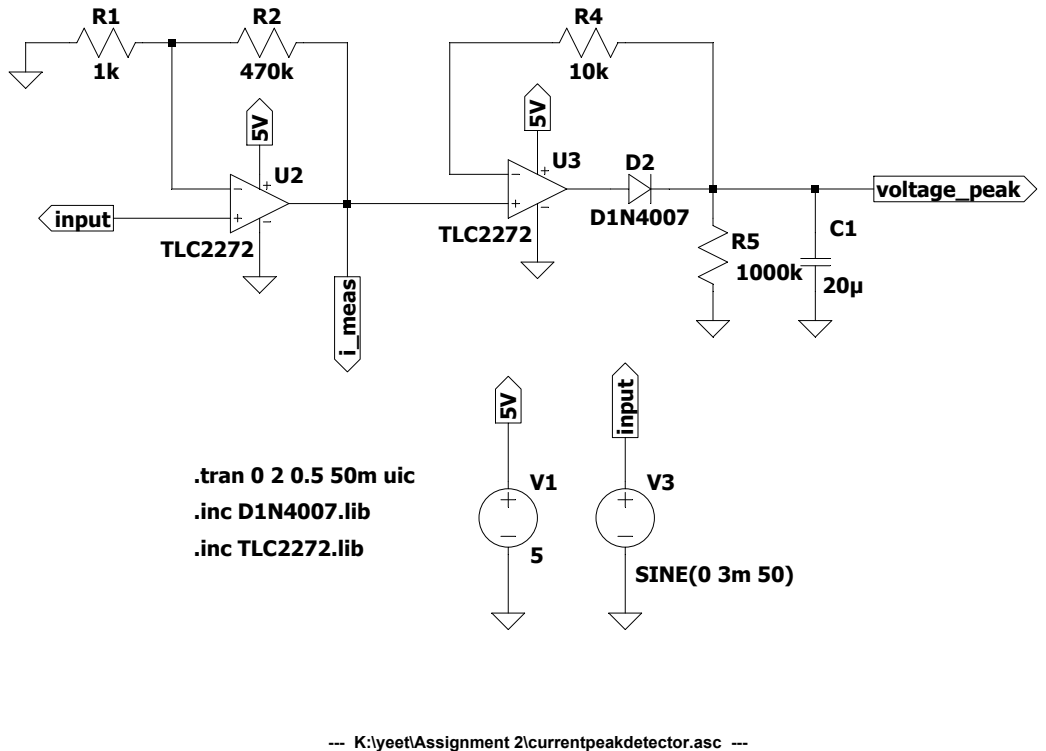
[picture p72: page 1]

--- K:\yeet\Assignment 2\currentpeakdetector.asc ---
