bradfourie/edesign_344/Reports/Fourie_20795629_A3/Figures/itrans_simu_change.pdf

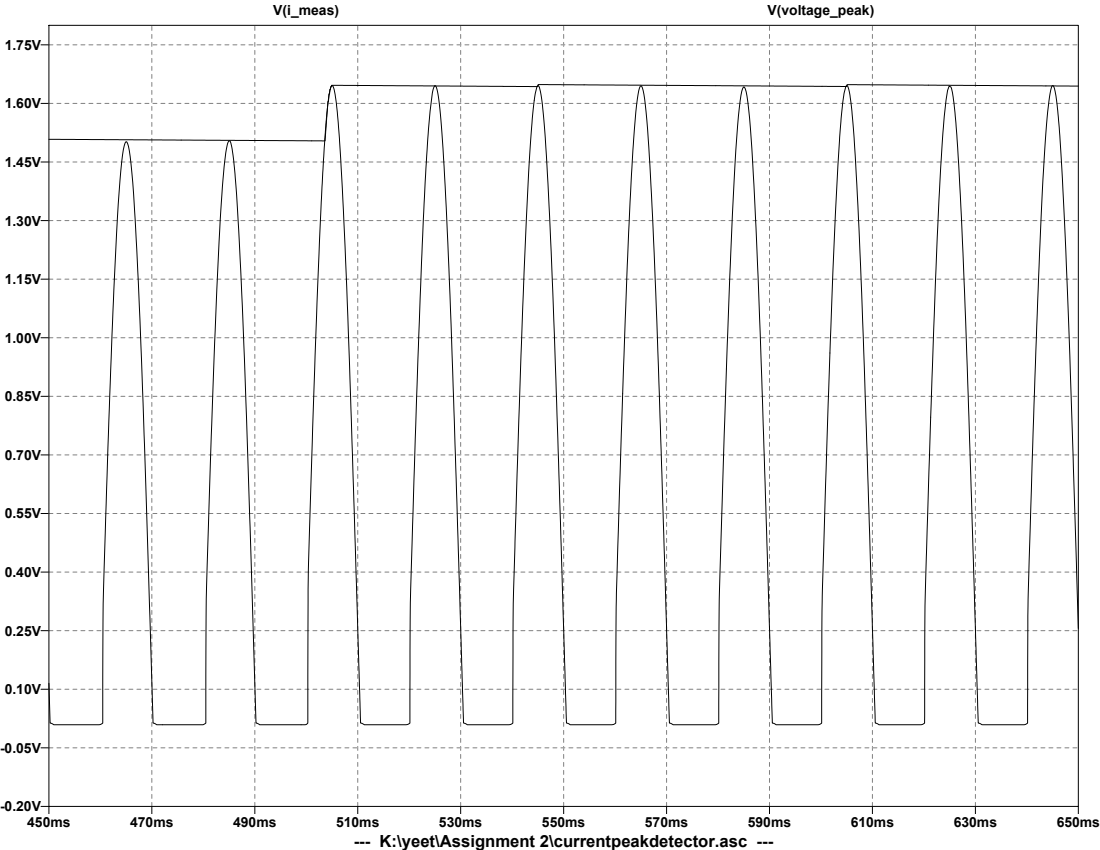
[picture p73: page 1]
V(i_meas); V(voltage_peak)

--- K:\yeet\Assignment 2\currentpeakdetector.asc ---
