bradfourie/edesign_344/Reports/Fourie_20795629_A3/Figures/itrans_simu_nomload.pdf

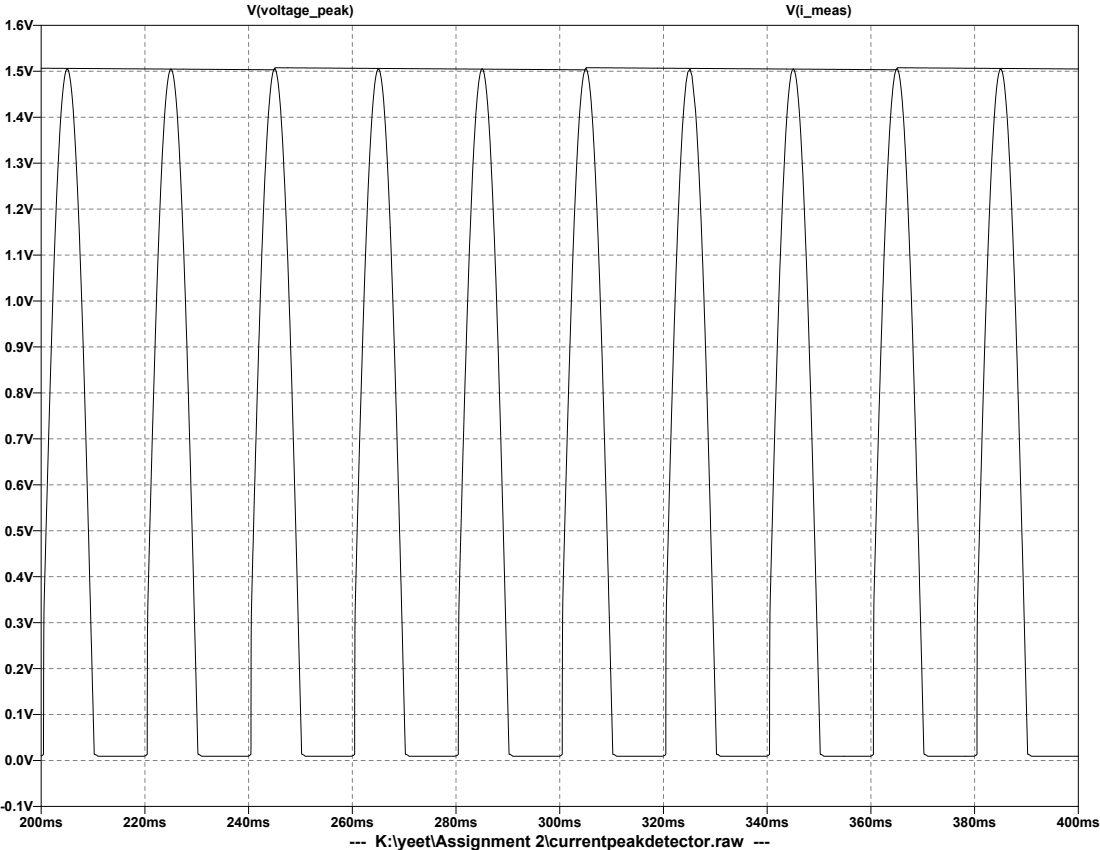
[picture p74: page 1]
V(voltage_peak); V(i_meas)

--- K:\yeet\Assignment 2\currentpeakdetector.raw ---
