bradfourie/edesign_344/Reports/Fourie_20795629_A3/Figures/vtrans_simu_nominput.pdf

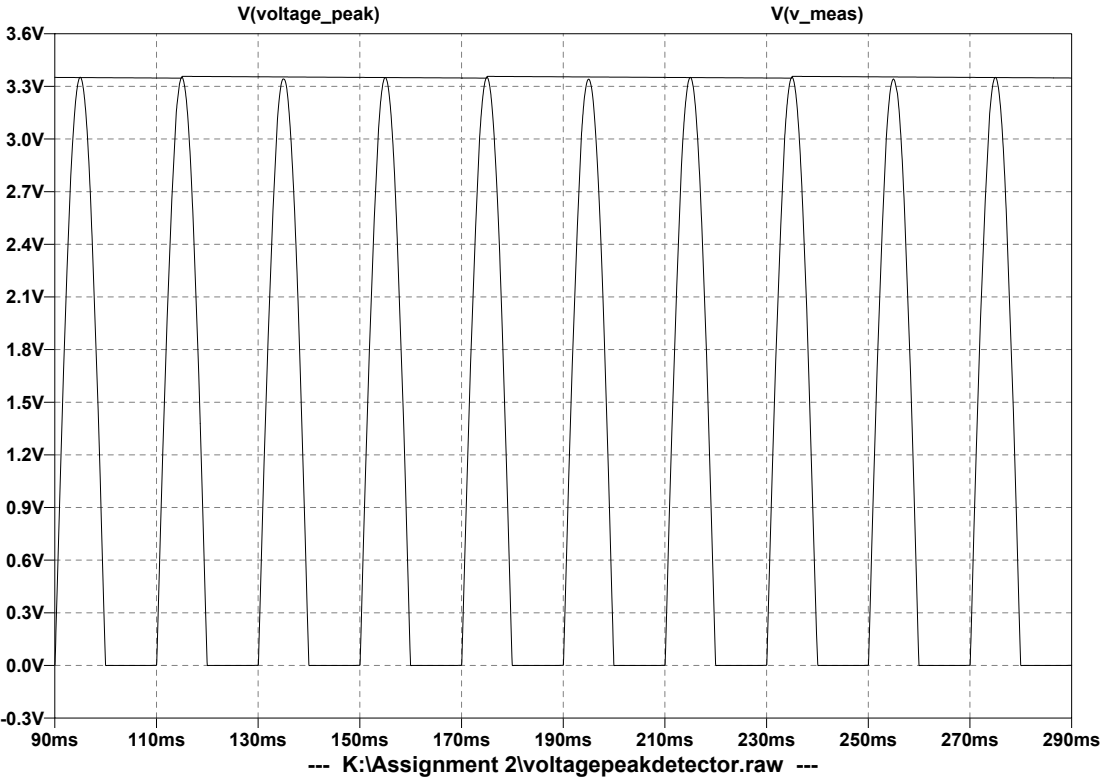
[picture p76: page 1]
V(voltage_peak); V(v_meas)

--- K:\Assignment 2\voltagepeakdetector.raw ---
