bradfourie/edesign_344/Reports/20795629_A2/Figures/voltagetransducer12vsim.pdf

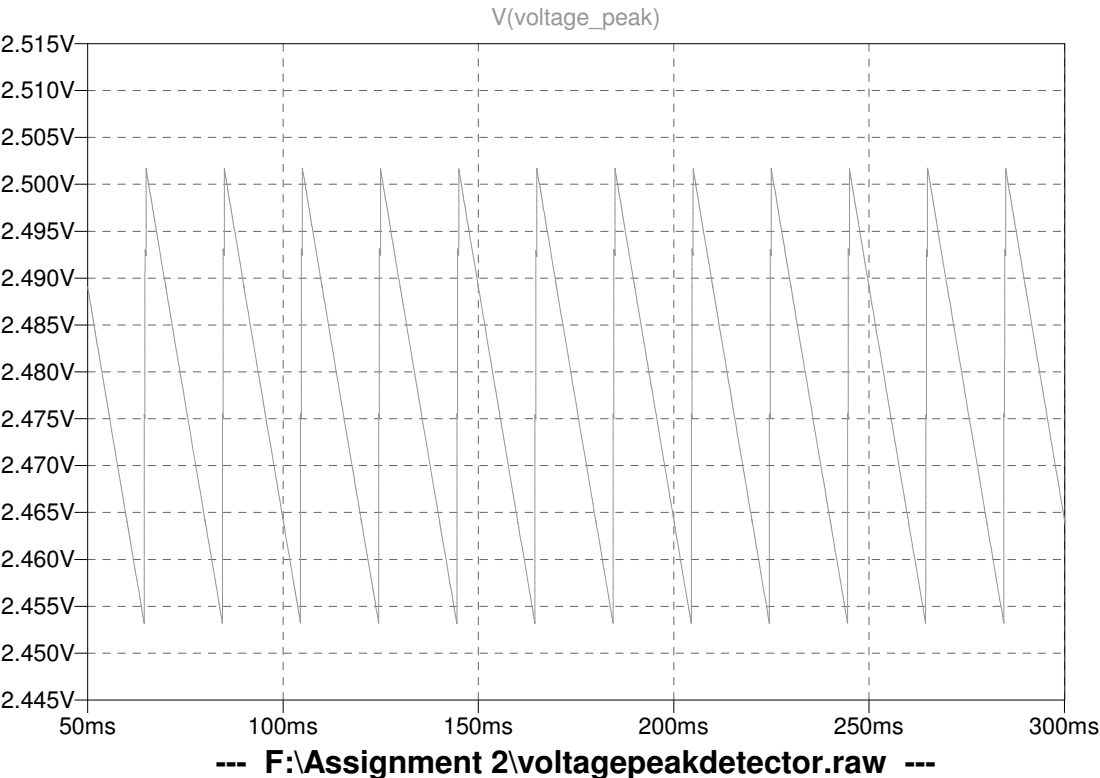
[picture p77: page 1]
V(voltage_peak)

--- F:\Assignment 2\voltagepeakdetector.raw ---
