bradfourie/edesign_344/Reports/20795629_A2/Figures/voltagetransducer20vsim.pdf

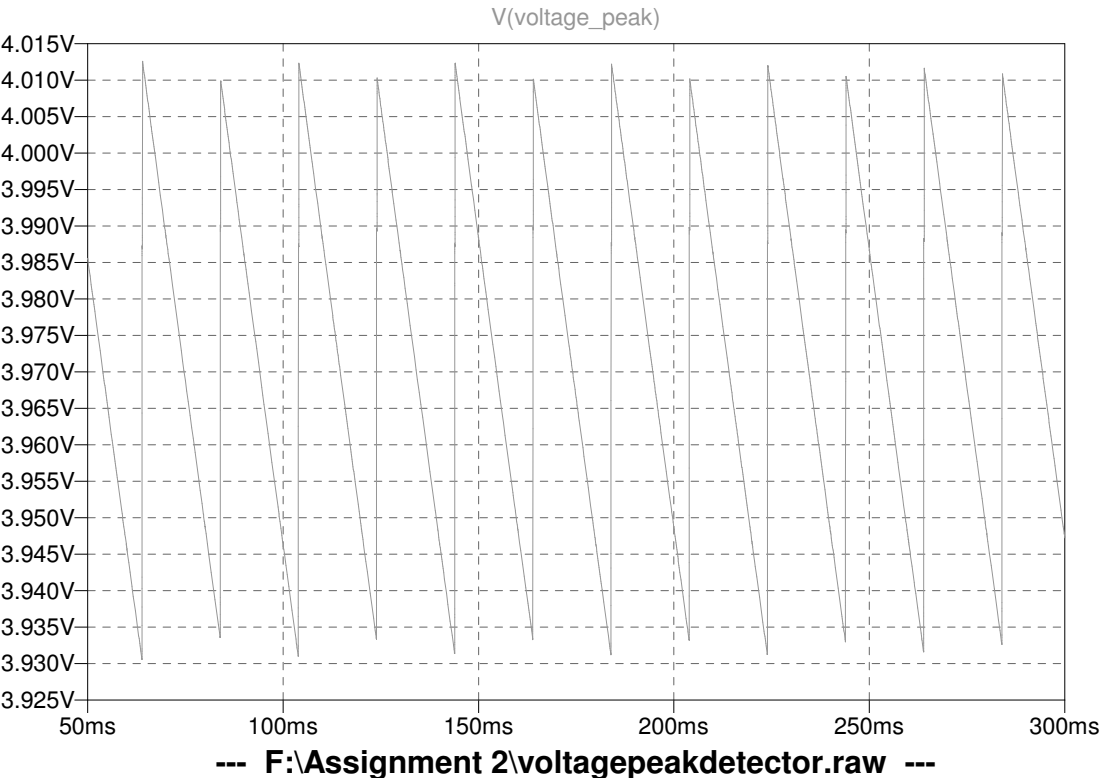
[picture p78: page 1]
V(voltage_peak)

--- F:\Assignment 2\voltagepeakdetector.raw ---
