bradfourie/edesign_344/Reports/20795629_A2/Figures/e-design_pwr.pdf

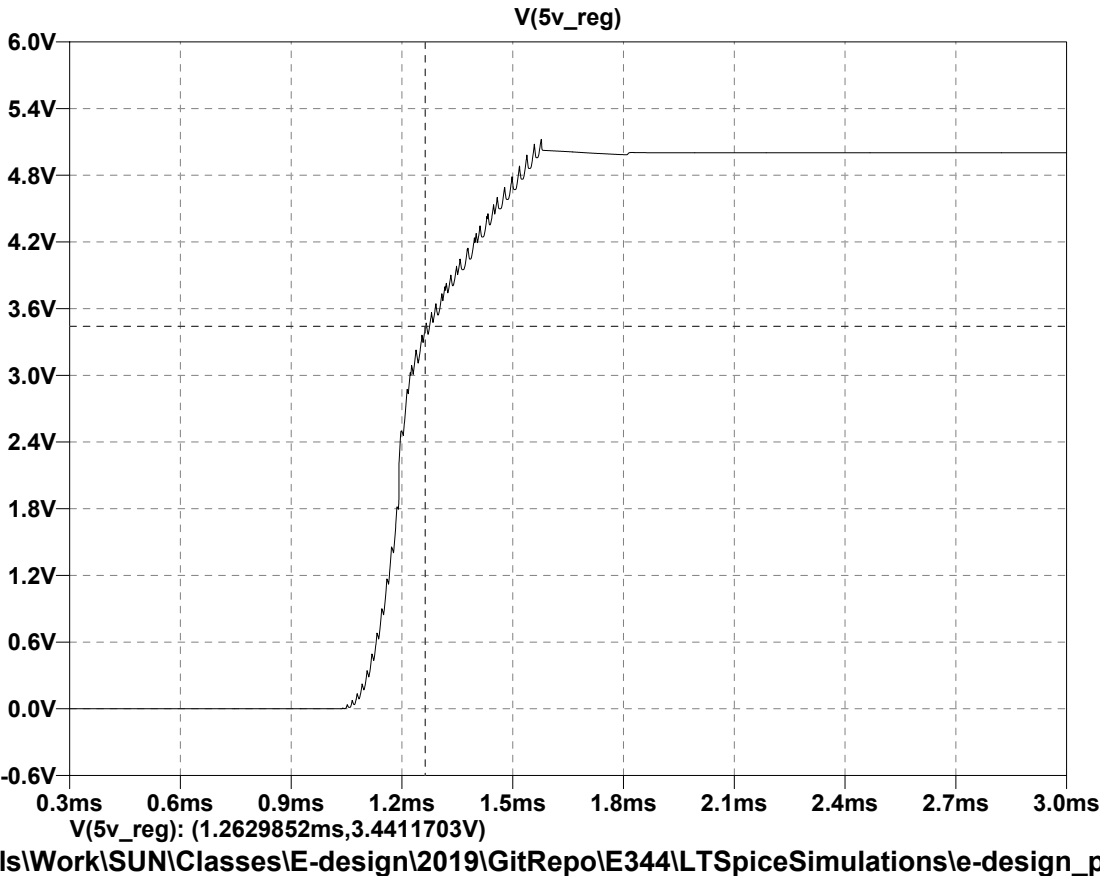
[picture p79: page 1]
V(5v_reg)

V(5v_reg): (1.2629852ms,3.4411703V)
ls\Work\SUN\Classes\E-design\2019\GitRepo\E344\LTSpiceSimulations\e-design_p
