bradfourie/edesign_344/Reports/Fourie_20795629_A3/Figures/circuit_diagram_power.pdf

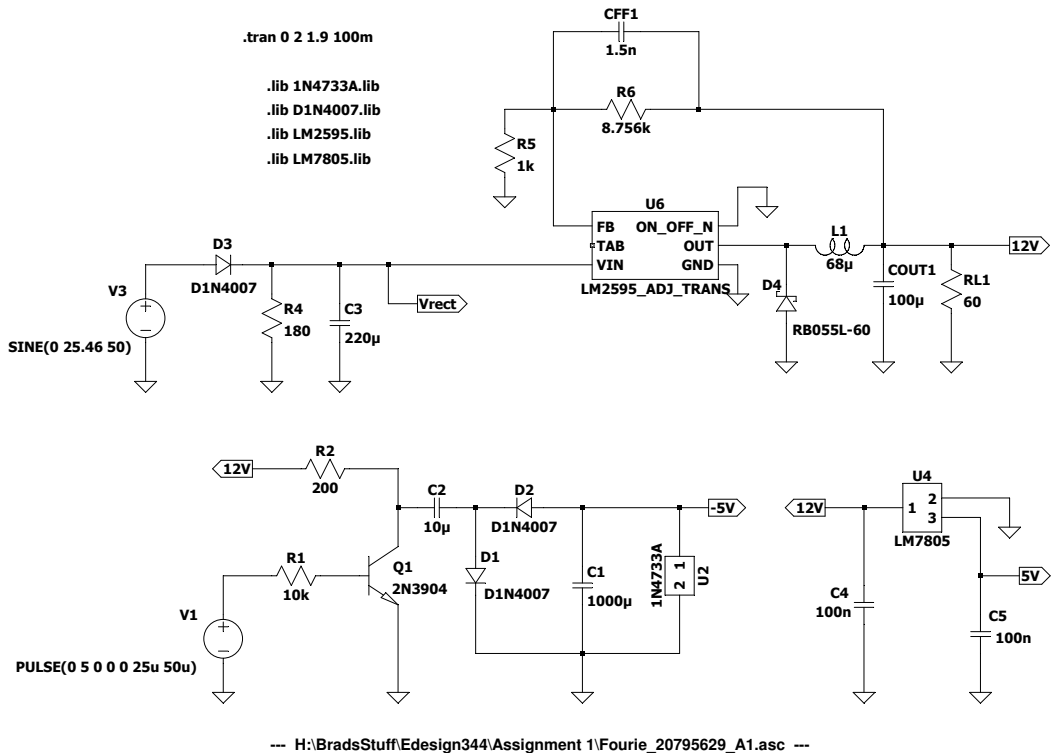
[picture p80: page 1]
