bradfourie/edesign_344/Reports/Fourie_20795629_A3/Figures/circuit_diagram_switch.pdf

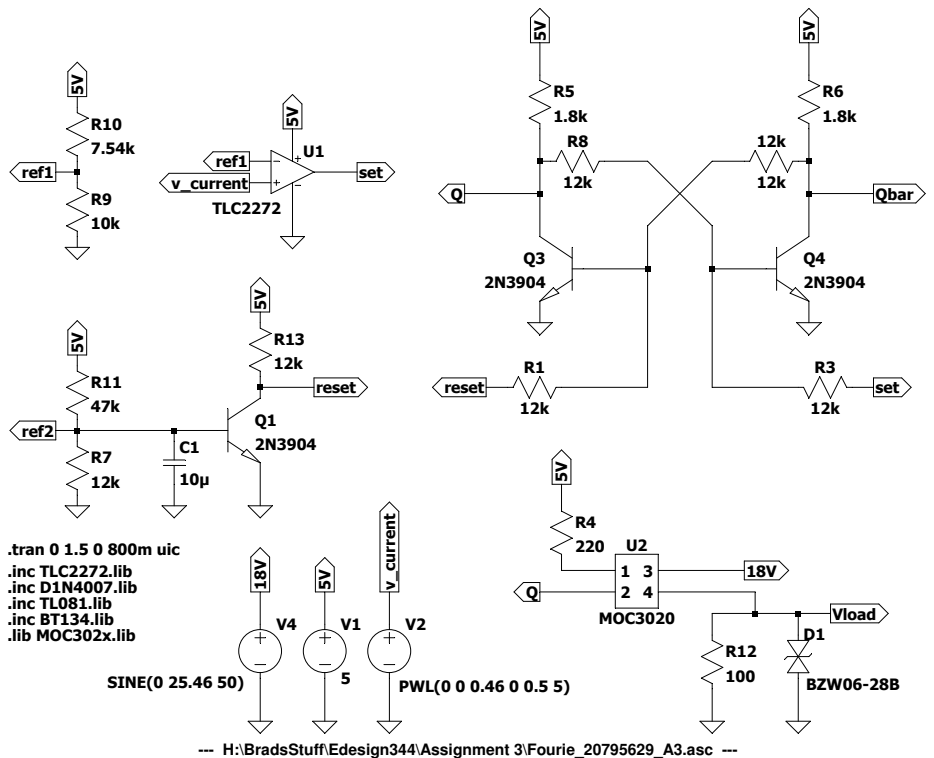
[picture p81: page 1]
