bradfourie/edesign_344/Reports/Fourie_20795629_A3/Figures/full_system.pdf

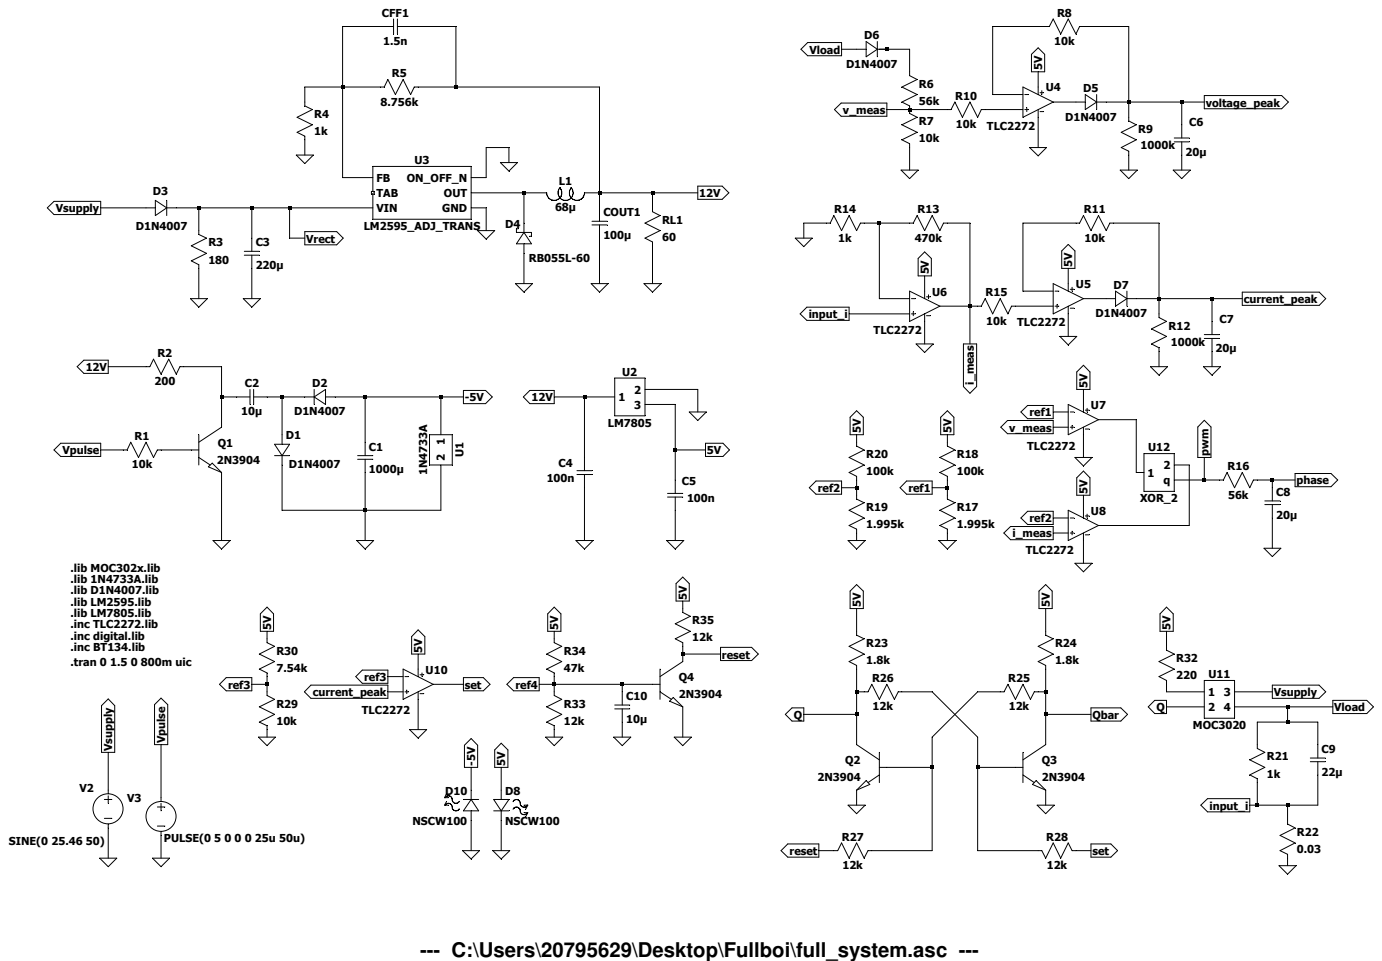
[picture p82: page 1]

--- C:\Users\20795629\Desktop\Fullboi\full_system.asc ---
