bradfourie/edesign_344/Reports/Fourie_20795629_A3/Figures/state_diagram_switch.pdf

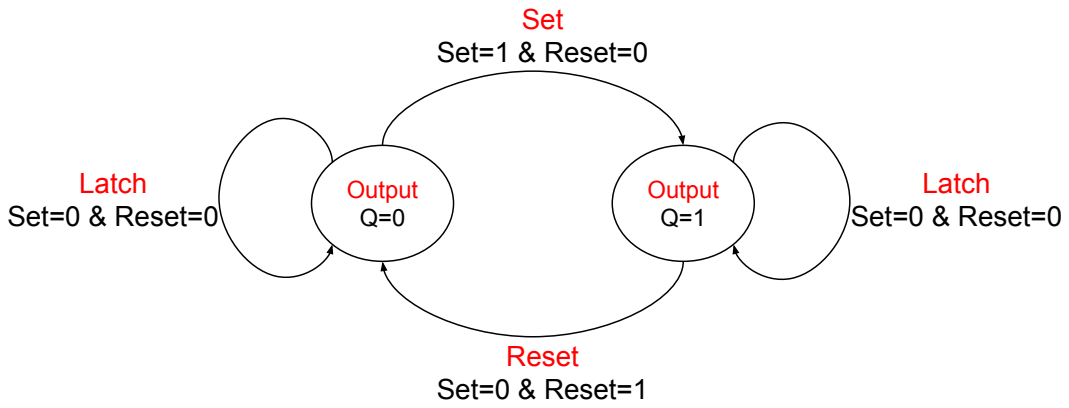
[picture p83: page 1]
Output Q=1; Output Q=0; Latch Set=0 & Reset=0; Set Set=1 & Reset=0; Reset Set=0 & Reset=1
