bradfourie/edesign_344/Reports/Fourie_20795629_A3/Figures/switch_simu_trip.pdf

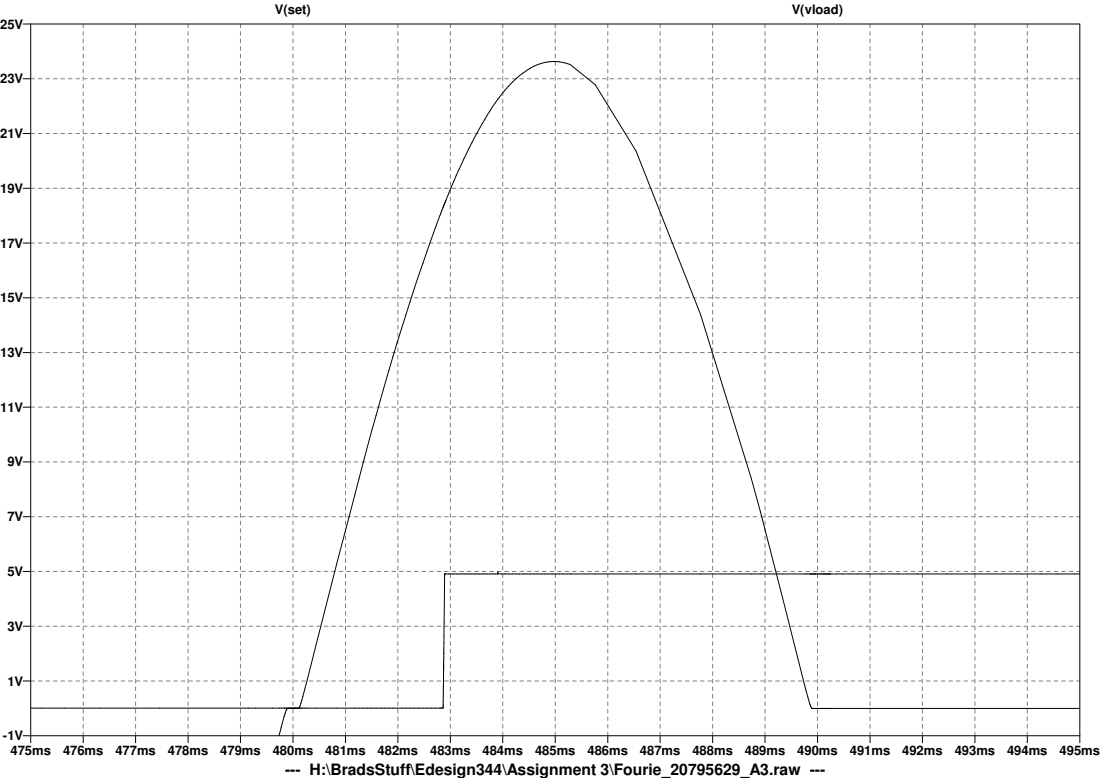
[picture p84: page 1]
V(set); V(vload)

--- H:\BradsStuff\Edesign344\Assignment 3\Fourie_20795629_A3.raw ---
