bradfourie/edesign_344/Reports/Fourie_20795629_A3/Figures/ptrans_circuit_diagram.pdf

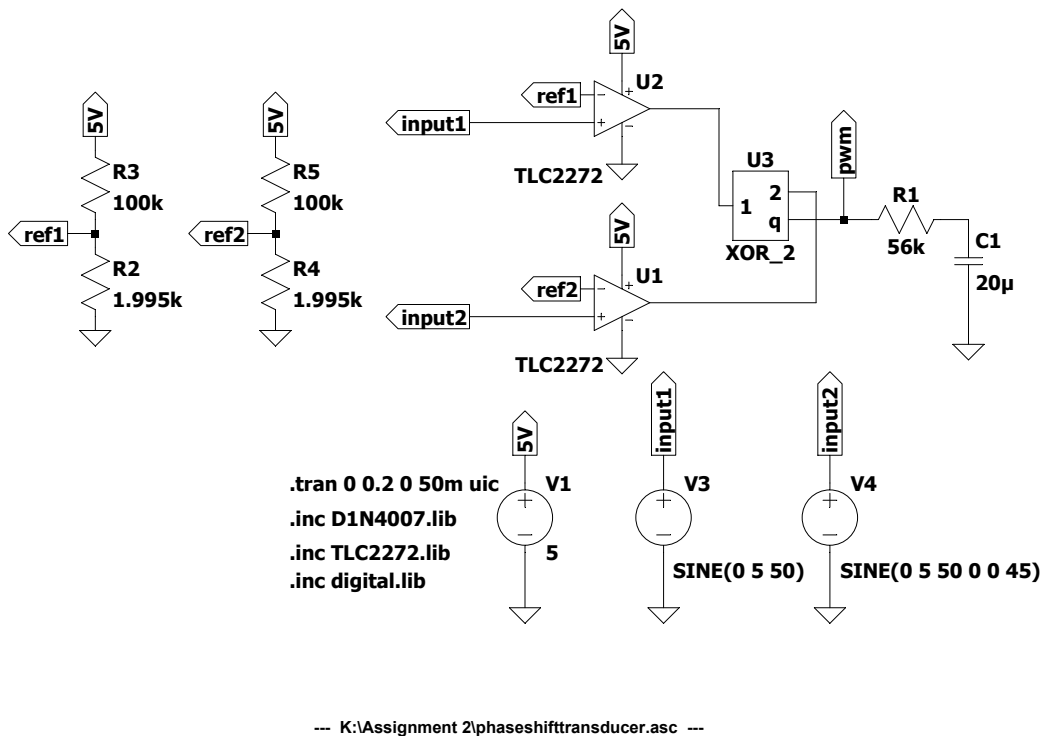
[picture p85: page 1]
