bradfourie/edesign_344/Reports/Fourie_20795629_A3/Figures/ptrans_simu_1k22u.pdf

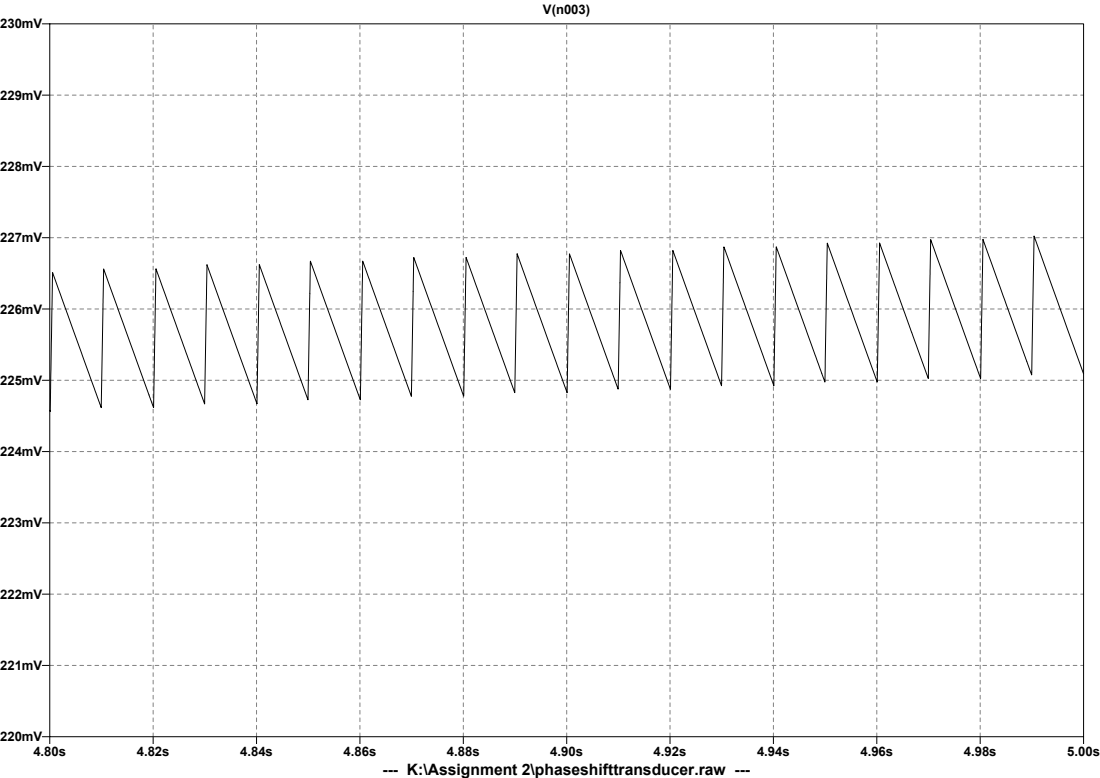
[picture p86: page 1]

--- K:\Assignment 2\phaseshifttransducer.raw ---
