bradfourie/edesign_344/Reports/Fourie_20795629_A3/Figures/ptrans_simu_1k33u.pdf

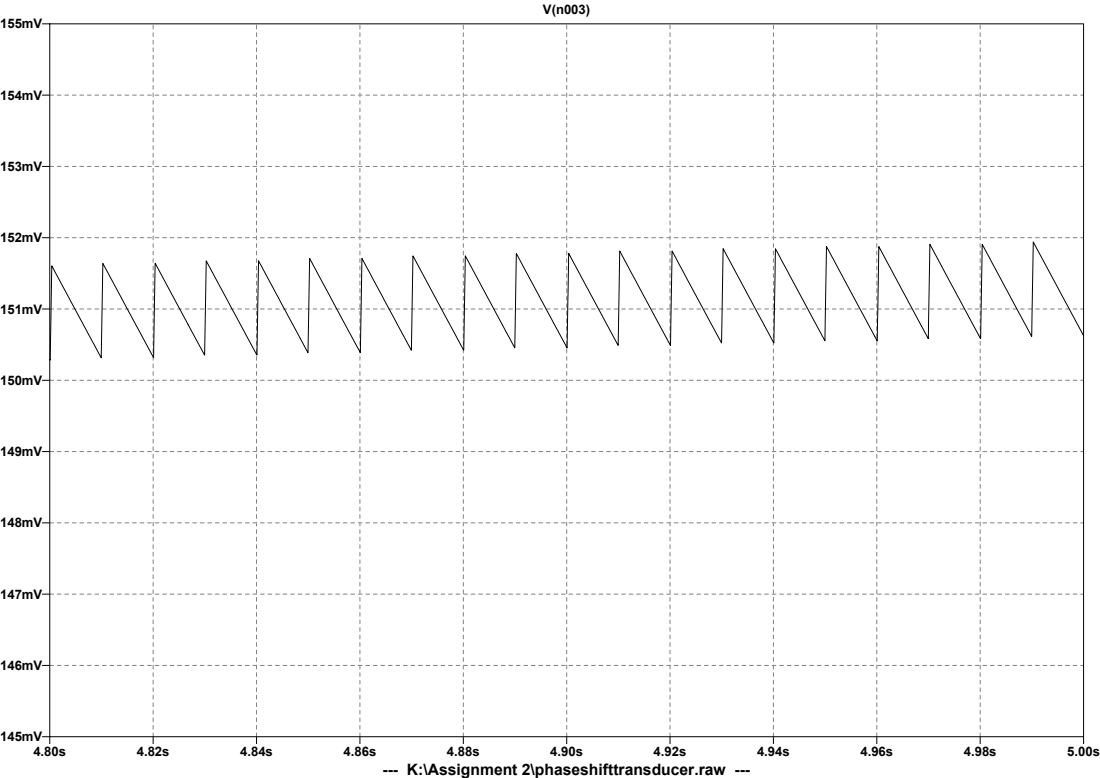
[picture p87: page 1]

--- K:\Assignment 2\phaseshifttransducer.raw ---
