bradfourie/edesign_344/Reports/Fourie_20795629_A3/Figures/vtrans_circuit_diagram.pdf

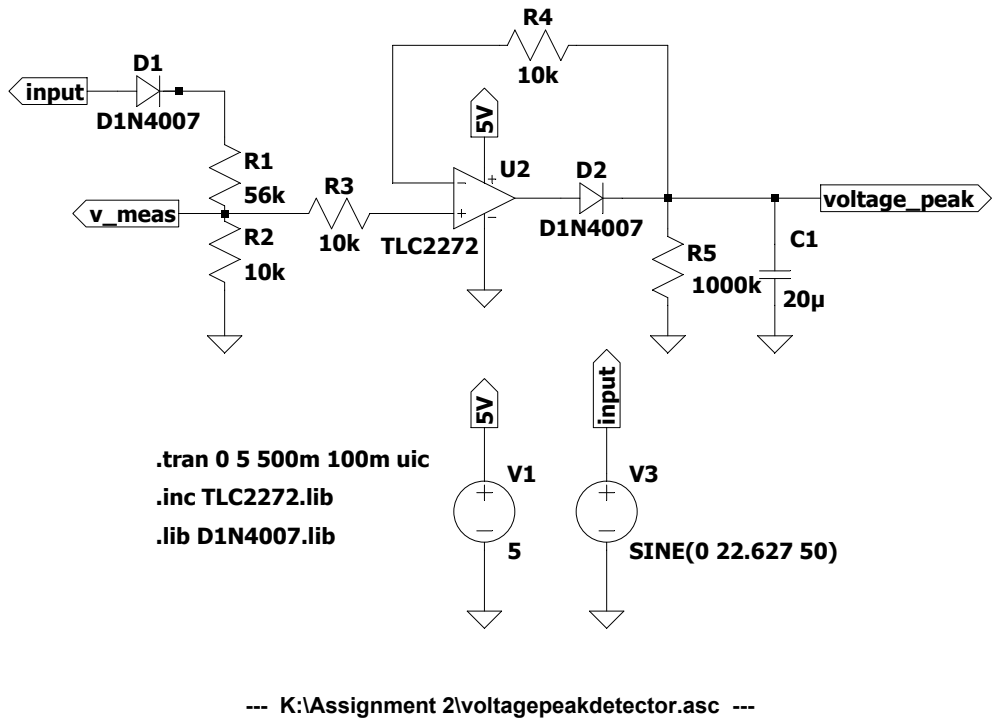
[picture p88: page 1]
