bradfourie/edesign_344/Reports/20795629_A2/Figures/currentpeakdetector.pdf

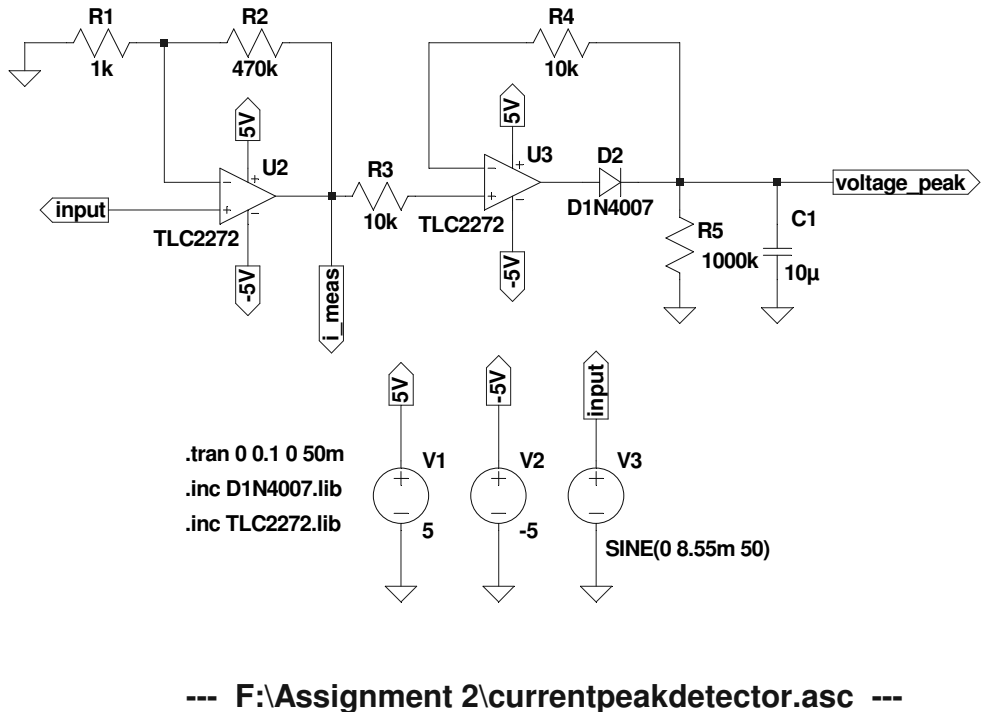
[picture p89: page 1]
