bradfourie/edesign_344/Reports/20795629_A2/Figures/voltagepeakdetector.pdf

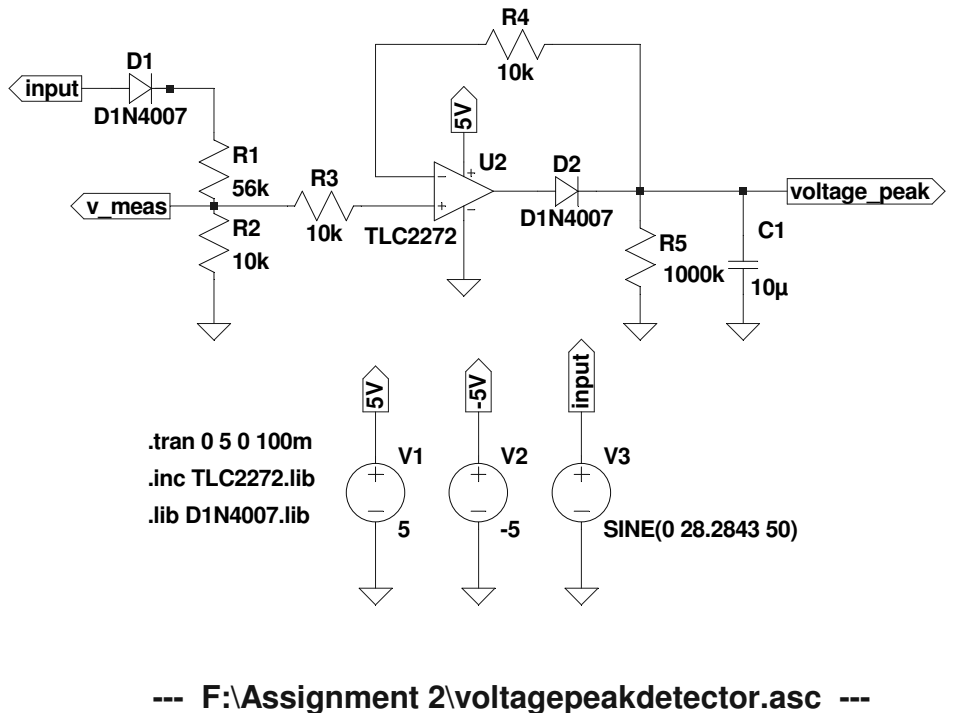
[picture p90: page 1]
