bradfourie/edesign_344/Reports/20795629_A2/Figures/e-design_pwr_ac.pdf

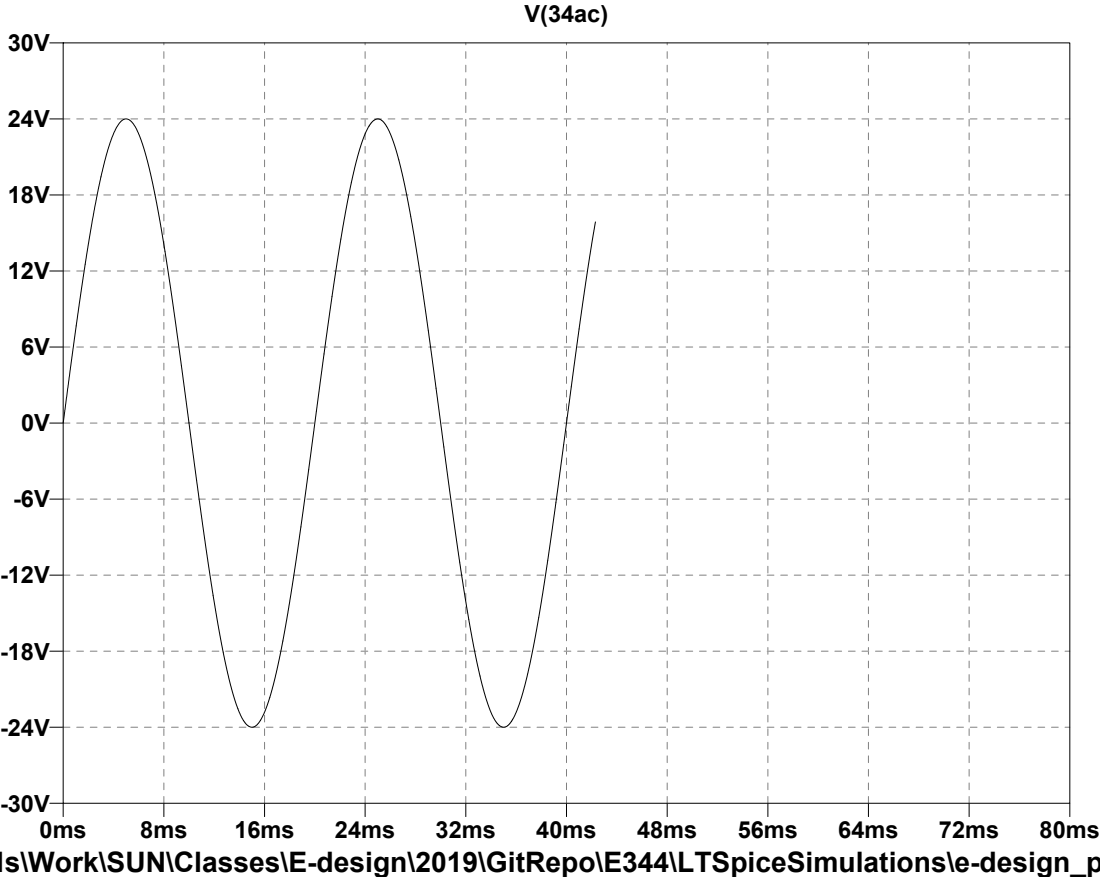
[picture p91: page 1]

ls\Work\SUN\Classes\E-design\2019\GitRepo\E344\LTSpiceSimulations\e-design_p
