bradfourie/edesign_344/Reports/Fourie_20795629_A1/Figures/charge_pump.asc

C1: cap; 1000µ
C2: cap; 10µ
D1: diode; D1N4007
D2: diode; D1N4007
Q1: npn; 2N3904
R1: res; 10k
R2: res; 200
U2: 1N4733At
V1: voltage; PULSE(0 5 0 0 0 25u 50u)
V3: voltage; 12
Named nets: 0
.tran 0 2 1.9 100m
.inc D1N4007.lib
.inc 1N4733At.lib
