bradfourie/edesign_344/LTSpice/Fourie_20795629_complete.asc

C1: cap; 1000µ
C2: cap; 10µ
C3: cap; 220µ; V=35
C4: cap; 100n
C5: cap; 100n
C6: cap; 20µ
C7: cap; 20µ
C8: cap; 20µ
C9: cap; 22µ
C10: cap; 10µ
CFF1: cap; 1.5n
COUT1: cap; 100µ; V=35
D1: diode; D1N4007
D2: diode; D1N4007
D3: diode; D1N4007
D4: schottky; RB055L-60
D5: diode; D1N4007
D6: diode; D1N4007
D7: diode; D1N4007
L1: ind; 68µ
Q1: npn; 2N3904
Q2: npn; 2N3904
Q3: npn; 2N3904
Q4: npn; 2N3904
R1: res; 10k
R2: res; 200
R3: res; 180
R4: res; 1k
R5: res; 8.756k
R6: res; 56k
R7: res; 10k
R8: res; 10k
R9: res; 1000k
R10: res; 10k
R11: res; 10k
R12: res; 1000k
R13: res; 470k
R14: res; 1k
R15: res; 10k
R16: res; 56k
R17: res; 1.995k
R18: res; 100k
R19: res; 1.995k
R20: res; 100k
R21: res; 1k
R22: res; 0.03
R23: res; 1.8k
R24: res; 1.8k
R25: res; 12k
R26: res; 12k
R27: res; 12k
R28: res; 12k
R29: res; 10k
R30: res; 7.54k
R32: res; 220
R33: res; 12k
R34: res; 47k
R35: res; 12k
RL1: res; 60
U1: 1N4733A
U2: LM7805
U3: LM2595_ADJ_TRANS
U4: opamp2; TLC2272
U5: opamp2; TLC2272
U6: opamp2; TLC2272
U7: opamp2; TLC2272
U8: opamp2; TLC2272
U10: opamp2; TLC2272
U11: MOC3020
U12: XOR_2
V2: voltage; SINE(0 25.46 50)
V3: voltage; PULSE(0 5 0 0 0 25u 50u)
Named nets: 0, -5V, 12V, 5V, Vrect, Vload, voltage_peak, v_meas, current_peak, input_i, i_meas, pwm, ref1, ref2, Vsupply, Vpulse, Qbar, Q, reset, set, ref3, ref4, phase
.lib 1N4733A.lib
.lib D1N4007.lib
.lib LM2595.lib
.lib LM7805.lib
.inc TLC2272.lib
.inc digital.lib
.tran 0 1.5 0 800m uic
.lib MOC302x.lib
.inc BT134.lib
