bradfourie/edesign_344/LTSpice/Fourie_20795629_A3.asc

12k: res; 12k
C1: cap; 10µ
Q1: npn; 2N3904
Q3: npn; 2N3904
Q4: npn; 2N3904
R1: res; 12k
R3: res; 12k
R4: res; 220
R5: res; 1.8k
R6: res; 1.8k
R7: res; 12k
R8: res; 12k
R9: res; 10k
R10: res; 13.216k
R11: res; 47k
R12: res; 100
R13: res; 12k
U1: opamp2; TLC2272
U3: MOC3020
V1: voltage; 5
V2: voltage; PWL(0 0 0.45 0 0.5 5)
V3: voltage; 0
V4: voltage; SINE(0 25.46 50)
Named nets: 0, 5V, v_current, Qbar, Q, reset, set, ref1, 18V, ref2
.inc D1N4007.lib
.tran 0 1.5 0 800m uic
.inc TL081.lib
.inc MOC302x.lib
.inc BT134.lib
.inc TLC2272.lib
