bradfourie/edesign_344/LTSpice/Fourie_20795629_A2.asc

C1: cap; 20µ
C2: cap; 20µ
C3: cap; 20µ
C4: cap; 22µ
D1: diode; D1N4007
D2: diode; D1N4007
D3: diode; D1N4007
R1: res; 56k
R2: res; 10k
R3: res; 10k
R4: res; 1000k
R5: res; 10k
R6: res; 10k
R7: res; 1000k
R8: res; 470k
R9: res; 1k
R10: res; 10k
R11: res; 56k
R12: res; 1.995k
R13: res; 100k
R14: res; 1.995k
R15: res; 100k
R16: res; 1k
R17: res; 0.03
U1: opamp2; TLC2272
U2: opamp2; TLC2272
U3: opamp2; TLC2272
U4: opamp2; TLC2272
U5: opamp2; TLC2272
U7: XOR_2
V1: voltage; 5
V2: voltage; SINE(0 22.627 50)
V4: voltage; -5
Named nets: 0, 5V, input_v, voltage_peak, v_meas, -5V, current_peak, input_i, i_meas, pwm, ref1, ref2
.inc D1N4007.lib
.inc TLC2272.lib
.tran 0 1.5 0 500m uic
.inc digital.lib
