bradfourie/edesign_344/LTSpice/Fourie_20795629_A1.asc

C1: cap; 1000µ
C2: cap; 10µ
C3: cap; 220µ; V=35
C4: cap; 100n
C5: cap; 100n
CFF1: cap; 1.5n
COUT1: cap; 100µ; V=35
D1: diode; D1N4007
D2: diode; D1N4007
D3: diode; D1N4007
D4: schottky; RB055L-60
L1: ind; 68µ
Q1: npn; 2N3904
R1: res; 10k
R2: res; 200
R3: res; 1k
R4: res; 180
R5: res; 1k
R6: res; 8.756k
R7: res; 125
RL1: res; 60
U1: 1N4733At
U3: LM2595_ADJ_TRANS
U5: LM7805
V1: voltage; PULSE(0 5 0 0 0 25u 50u)
V3: voltage; SINE(0 25.46 50)
Named nets: 0
.tran 0 2 1.9 100m
.lib C:\\Users\\User\\Desktop\\Edesign344\\1N4733At.lib
.lib C:\\Users\\User\\Desktop\\Edesign344\\D1N4007.lib
.lib C:\\Users\\User\\Desktop\\Edesign344\\lm2595.lib
.lib C:\\Users\\User\\Desktop\\Edesign344\\lm7805.lib
