bradfourie/edesign_344/Python/gui.py

from tkinter import Tk, ttk, mainloop, Frame, Text, END
from connection import ConnectionStatus, BeetleConnection
from tkinter import *
import tkinter.messagebox
import tkinter as tk
from time import sleep

import matplotlib
matplotlib.use('TkAgg')
from matplotlib.backends.backend_tkagg import FigureCanvasTkAgg, NavigationToolbar2TkAgg
from matplotlib.figure import Figure
import matplotlib.animation as animation
from matplotlib import style

import math 

class App(tk.Tk):
    connectframe = -1
    diagnosticframe = -1
    homeframe = -1
    container_global = -1
    voltage_measurements = []
    current_measurements = []
    phase_measurements = []
    time_measurements = []
    runtime = -1
    trip_status = "LOW"
    display_time = 60
    total_real_power = 0
    total_reactive_power = 0
	
    def __init__(self, *args, **kwargs):    
        tk.Tk.__init__(self, *args, **kwargs)
        container = tk.Frame(self)
        container.grid(row=0, column = 0, sticky='nsew')

        self.__create_connection()
        self.container_global = container
		
        self.title("Smart Power Meter")
        self.call('wm', 'iconphoto', self.winfo_toplevel()._w, tk.PhotoImage(file='baseline_power_black_24dp.png'))
        
        self.geometry("655x660")
        self.resizable(False, False)

        self.diagnosticframe= DiagnosticFrame(self.container_global, self)
        self.diagnosticframe.grid(row=2, column = 0, sticky='NEWS')
		
        self.connectframe= ConnectionFrame(container, self)
        self.connectframe.grid(row=1, column = 0, sticky='NEWS')	

        self.homeframe= HomeFrame(container, self)
        self.homeframe.grid(row=2, column = 0, sticky='NEWS')	
		
        self.remove_grid_diagnostic_frame()
        self.remove_grid_connection_frame()
        #self.remove_grid_home_frame()
		
        self.after(1000, self.sample_data)#self.printSerialReturn())
		
    def sample_data(self):
        if self.connection.is_connected():
           self.parse_input()
        self.after(1000, self.sample_data)
        self.runtime=self.runtime+1
		
    def parse_input(self):
        sleep(0.05)
        input_list = self.connection.receive()
        #print(input_list)
        allocated = False
        for x in range(len(input_list)): 
            if(input_list[x] == 'U\r'): #uptime condition
                self.connectframe.writeToScreen(input_list[x] + ', ' + input_list[x+1])
                allocated = True
            if(input_list[x] == 'X\r'): #debug condition
                self.connectframe.writeToScreen(input_list[x] + ', ' + input_list[x+1])
                allocated = True
            if(input_list[x] == '0\r' and input_list[x-1] != '0\r' and input_list[x-1] != '1\r' and input_list[x-1] != '2\r'):	#student number condition
                self.connectframe.writeToScreen(input_list[x] + ', ' + input_list[x+1] )		
                allocated = True
            if(input_list[x] == '1\r' and input_list[x-1] != '0\r' and input_list[x-1] != '1\r' and input_list[x-1] != '2\r'):	#analog reading condition
                self.connectframe.writeToScreen(input_list[x] + ', ' + input_list[x+1] + ', ' + input_list[x+2])	
                allocated = True				
            if(input_list[x] == '2\r' and input_list[x-1] != '0\r' and input_list[x-1] != '1\r' and input_list[x-1] != '2\r'):	#digital reading condition
                self.connectframe.writeToScreen(input_list[x] + ', ' + input_list[x+1] + ', ' + input_list[x+2])	
                allocated = True				
            if allocated == False and input_list[x] != "[]": 
                self.update_live_data(input_list[x])
                allocated = True	      
		
    def update_live_data(self, input_string):
        measurements = input_string.split()
        self.trip_status = measurements[3]
        self.phase_measurements.append(float(measurements[0]))
        self.current_measurements.append(float(measurements[1]))
        self.voltage_measurements.append(float(measurements[2]))
        self.time_measurements.append(self.runtime)
        if(self.runtime > self.display_time):
            self.phase_measurements.pop(0)
            self.current_measurements.pop(0)
            self.voltage_measurements.pop(0)
            self.time_measurements.pop(0)
        print(input_string)
        self.diagnosticframe.updateUI(self)
        self.homeframe.updateUI(self)			
			
    #going to home frame from other frames
    def show_home_frame_from_diagnostic_frame(self):
        self.remove_grid_diagnostic_frame()
			
        self.setup_grid_home_frame()
        self.connectframe.tkraise()	

    def show_home_frame_from_connection_frame(self):
        self.remove_grid_connection_frame()
			
        self.setup_grid_home_frame()
        self.connectframe.tkraise()	
		
    #going to diagnostic frame from other frames
    def show_diagnostic_frame_from_connection_frame(self):
        self.remove_grid_connection_frame()	
		
        self.setup_grid_diagnostic_frame()
        self.diagnosticframe.tkraise()	

    def show_diagnostic_frame_from_home_frame(self):
        self.remove_grid_home_frame()	
		
        self.setup_grid_diagnostic_frame()
        self.diagnosticframe.tkraise()	
		
    #going to connection frame from other frames
    def show_connection_frame_from_home_frame(self):
        self.remove_grid_home_frame()	
		
        self.setup_grid_connection_frame()
        self.diagnosticframe.tkraise()	

    def show_connection_frame_from_diagnostic_frame(self):
        self.remove_grid_diagnostic_frame()	
		
        self.setup_grid_connection_frame()
        self.diagnosticframe.tkraise()	


    def setup_grid_connection_frame(self):
        self.config(menu=self.connectframe.menubar)
        self.connectframe.statusbar.grid(column=0, row=7, padx=5, pady=5, sticky="WES", columnspan=4)
        self.connectframe.page_title_label.grid(column=0, row=0, padx=100, pady=5, columnspan=4)			
        self.connectframe.device_picker.grid(column=2, row=1, padx=5, pady=5,  sticky="WE", columnspan=2)		
        self.connectframe.device_label.grid(column=0, row=1, padx=5, pady=5, sticky="W", columnspan=2)
        self.connectframe.connect_button.grid(column=0, row=2,padx=5, pady=5, sticky="WE", columnspan=4)
        self.connectframe.type_label.grid(column=0, row=3,padx=5, pady=5, sticky="W")	
        self.connectframe.type_entry.grid(column=1, row=3,padx=5, pady=5, sticky="E", columnspan=1)
        self.connectframe.port_label.grid(column=2, row=3,padx=5, pady=5, sticky="W")
        self.connectframe.port_entry.grid(column=3, row=3,padx=5, pady=5, sticky="E", columnspan=1)	
        self.connectframe.request_button.grid(column=0, row=4,padx=5, pady=5, sticky="WE", columnspan=4)
        self.connectframe.clear_button.grid(column=0, row=6,padx=5, pady=5, sticky="WE", columnspan=2)
        self.connectframe.Uptime_button.grid(column=2, row=6, padx=5, pady=5, sticky="WE", columnspan=2)
        self.connectframe.return_text.grid(column=0, row=5, padx=5, pady=5, sticky="WE", columnspan=4)	
		
    def remove_grid_connection_frame(self):
        self.connectframe.menubar.grid_forget()	
        self.connectframe.statusbar.grid_forget()
        self.connectframe.page_title_label.grid_forget()	
        self.connectframe.device_picker.grid_forget()		
        self.connectframe.device_label.grid_forget()
        self.connectframe.connect_button.grid_forget()
        self.connectframe.type_label.grid_forget()		
        self.connectframe.type_entry.grid_forget()	
        self.connectframe.port_label.grid_forget()
        self.connectframe.port_entry.grid_forget()		
        self.connectframe.request_button.grid_forget()
        self.connectframe.clear_button.grid_forget()
        self.connectframe.Uptime_button.grid_forget()
        self.connectframe.return_text.grid_forget()	 

    def setup_grid_diagnostic_frame(self):
        self.config(menu=self.diagnosticframe.menubar)
        self.diagnosticframe.page_title_label.grid(column=0, row=0, padx=230, pady=5,sticky="NSEW", columnspan=4)
        self.diagnosticframe.voltage_canvas.get_tk_widget().grid(column=0, row=1, padx=10, pady=0,sticky="WE", columnspan=4, rowspan=3)
        self.diagnosticframe.current_canvas.get_tk_widget().grid(column=0, row=4, padx=10, pady=0,sticky="WE", columnspan=4, rowspan=3)
        self.diagnosticframe.phase_canvas.get_tk_widget().grid(column=0, row=7, padx=10, pady=0,sticky="WE", columnspan=4, rowspan=3)
        self.diagnosticframe.statusbar.grid(column=0, row=13, padx=5, pady=0, sticky="WES", columnspan=4)
        #self.diagnosticframe.reset_button.grid(column=0, row=12, padx=5, pady=5, sticky="WES", columnspan=4)	
		
    def remove_grid_diagnostic_frame(self):
        self.diagnosticframe.page_title_label.grid_forget()
        self.diagnosticframe.menubar.grid_forget()
        self.diagnosticframe.voltage_canvas.get_tk_widget().grid_forget()
        self.diagnosticframe.current_canvas.get_tk_widget().grid_forget()			
        self.diagnosticframe.phase_canvas.get_tk_widget().grid_forget()
        self.diagnosticframe.statusbar.grid_forget()
        #self.diagnosticframe.reset_button.grid_forget()

    def setup_grid_home_frame(self):	
        self.config(menu=self.homeframe.menubar)
        self.homeframe.page_title_label.grid(column=0, row=0, padx=230, pady=5,sticky="NSEW", columnspan=4)		
        self.homeframe.newest_measurements_label.grid(column=0, row=1, padx=230, pady=20,sticky="NSEW", columnspan=4)		
        self.homeframe.newest_measurements_label.config(font=("Calibri", 14))
        self.homeframe.newest_voltage_label.grid(column=0, row=2, padx=20, pady=5,sticky="W", columnspan=1)	
        self.homeframe.newest_voltage_entry.grid(column=3, row=2,padx=20, pady=5, sticky="E", columnspan=1)		
        self.homeframe.newest_current_label.grid(column=0, row=3, padx=20, pady=5,sticky="W", columnspan=1)
        self.homeframe.newest_current_entry.grid(column=3, row=3,padx=20, pady=5, sticky="E", columnspan=1)		
        self.homeframe.newest_phase_label.grid(column=0, row=4, padx=20, pady=5,sticky="W", columnspan=1)	
        self.homeframe.newest_phase_entry.grid(column=3, row=4,padx=20, pady=5, sticky="E", columnspan=1)				
        self.homeframe.newest_real_power_label.grid(column=0, row=5, padx=20, pady=5,sticky="W", columnspan=1)	
        self.homeframe.newest_real_power_entry.grid(column=1, row=5,padx=20, pady=5, sticky="E", columnspan=1)			
        self.homeframe.newest_reactive_power_label.grid(column=2, row=5, padx=20, pady=5,sticky="W", columnspan=1)	
        self.homeframe.newest_reactive_power_entry.grid(column=3, row=5,padx=20, pady=5, sticky="E", columnspan=1)			
        self.homeframe.total_power_label.grid(column=0, row=6, padx=250, pady=20,sticky="SEW", columnspan=4)		
        self.homeframe.total_real_power_label.grid(column=0, row=7, padx=20, pady=5,sticky="W", columnspan=1)	
        self.homeframe.total_real_power_entry.grid(column=1, row=7,padx=20, pady=5, sticky="E", columnspan=1)	
        self.homeframe.total_reactive_power_label.grid(column=2, row=7, padx=20, pady=5,sticky="W", columnspan=1)	
        self.homeframe.total_reactive_power_entry.grid(column=3, row=7,padx=20, pady=5, sticky="E", columnspan=1)
        self.homeframe.system_status_label.grid(column=0, row=8, padx=270, pady=20,sticky="SEW", columnspan=4)
        self.homeframe.trip_status_label.grid(column=0, row=9, padx=20, pady=5,sticky="W", columnspan=1)	
        self.homeframe.trip_status_entry.grid(column=3, row=9,padx=20, pady=5, sticky="E", columnspan=1)
        self.homeframe.connection_status_label.grid(column=0, row=10, padx=20, pady=5,sticky="W", columnspan=1)	
        self.homeframe.connection_status_entry.grid(column=3, row=10,padx=20, pady=5, sticky="E", columnspan=1)	    
        self.homeframe.reset_button.grid(column=0, row=11, padx=20, pady=5, sticky="WES", columnspan=4)		
        self.homeframe.labelImage.grid(column=0, row=12, padx=20, pady=5, sticky="SEW", columnspan=4)
		
    def remove_grid_home_frame(self):		
        self.homeframe.menubar.grid_forget()	
        self.homeframe.page_title_label.grid_forget()		
        self.homeframe.newest_measurements_label.grid_forget()		
        self.homeframe.newest_measurements_label.grid_forget()
        self.homeframe.newest_voltage_label.grid_forget()
        self.homeframe.newest_voltage_entry.grid_forget()	
        self.homeframe.newest_current_label.grid_forget()
        self.homeframe.newest_current_entry.grid_forget()
        self.homeframe.newest_phase_label.grid_forget()
        self.homeframe.newest_phase_entry.grid_forget()				
        self.homeframe.newest_real_power_label.grid_forget()	
        self.homeframe.newest_real_power_entry.grid_forget()			
        self.homeframe.newest_reactive_power_label.grid_forget()
        self.homeframe.newest_reactive_power_entry.grid_forget()			
        self.homeframe.total_power_label.grid_forget()		
        self.homeframe.total_real_power_label.grid_forget()
        self.homeframe.total_real_power_entry.grid_forget()
        self.homeframe.total_reactive_power_label.grid_forget()
        self.homeframe.total_reactive_power_entry.grid_forget()
        self.homeframe.system_status_label.grid_forget()
        self.homeframe.trip_status_label.grid_forget()	
        self.homeframe.trip_status_entry.grid_forget()
        self.homeframe.connection_status_label.grid_forget()	
        self.homeframe.connection_status_entry.grid_forget()	
        self.homeframe.reset_button.grid_forget()
        self.homeframe.labelImage.grid_forget()	
		
    def __create_connection(self):
        self.connection = BeetleConnection()

        def connection_callback(state):
            if state == ConnectionStatus.DISCONNECTED:
                self.connectframe.event_disconnected(self)
                self.homeframe.event_disconnected(self)
            elif state == ConnectionStatus.CONNECTED:
                self.connectframe.event_connected(self)
                self.homeframe.event_connected(self)
            elif state == ConnectionStatus.FAILED_TO_CONNECT:
                self.connectframe.event_failed_to_connect(self)
                self.homeframe.event_failed_to_connect(self)
            elif state == ConnectionStatus.DISCONNECTED_TIMEOUT:
                self.connectframe.event_disconnected_timeout(self)
                self.homeframe.event_disconnected_timeout(self)
            elif state == ConnectionStatus.DISCONNECTED_ERROR:
                self.connectframe.event_disconnected_error(self)
                self.homeframe.event_disconnected_error(self)
            else:
                raise Exception("Unhandled connection callback")

        self.connection.register_status_callback(connection_callback)
			
class ConnectionFrame(Frame):
    def __set_connected_button(self, controller):
        def connect_button_callback():
            controller.connection.disconnect()

        controller.connection.write(b"U")
        controller.connection.write(b"\n")

        self.connect_button["command"] = connect_button_callback
        self.connect_button["text"] = "Disconnect"
        self.device_picker["state"] = "disabled"

    def __set_disconnected_button(self, controller):
        def connect_button_callback():
            device = self.device_picker.get()
            controller.connection.connect(device)

        self.connect_button["command"] = connect_button_callback
        self.connect_button["text"] = "Connect"

        self.device_picker["state"] = "normal"

    def __init__(self, parent, controller):
        tk.Frame.__init__(self, parent)
		
        self.controller = controller
		#code for adding a submenu to swap frames
		#code for main connection frame)
		#create the menubar
        self.menubar = Menu(controller)
        controller.config(menu=self.menubar)	
	    #create the submenu
        self.subMenu = Menu(self.menubar)
        self.menubar.add_cascade(label="Navigation",menu=self.subMenu)
        self.subMenu.add_command(label="Home", command=lambda: controller.show_home_frame_from_connection_frame())
        self.subMenu.add_command(label="Connection")
        self.subMenu.add_command(label="Diagnostic", command=lambda: controller.show_diagnostic_frame_from_connection_frame())
        self.subMenu.add_command(label="Exit", command= self.winfo_toplevel().destroy)
		
        def about_project():
            tkinter.messagebox.showinfo('About Project', 'This application is a connection and diagnostics viewer and was made by Bradley Fourie for the EDesign344 course at Stellenboch University.')
	
        self.subMenu = Menu(self.menubar)
        self.menubar.add_cascade(label="Help",menu=self.subMenu)
        self.subMenu.add_command(label="About", command= about_project)
		
		#create the statusbar
        self.statusbar = Label(self.winfo_toplevel(), text="Connection Status: Disconnected", relief=SUNKEN)
        self.statusbar.grid(column=0, row=7, padx=5, pady=5, sticky="WES", columnspan=4)
		
		#create the page title
        self.page_title_label = ttk.Label(self.winfo_toplevel(), text="Connections Manager")
        self.page_title_label.grid(column=0, row=0, padx=100, pady=5, columnspan=4)		
        self.page_title_label.config(font=("Calibri", 18))	
   
		#create the device picker
		#row1
        self.device_picker = ttk.Combobox(self.winfo_toplevel(), values=())
        self.device_picker.grid(column=2, row=1, padx=5, pady=5,  sticky="WE", columnspan=2)
		#row2
        self.device_label = ttk.Label(self.winfo_toplevel(), text="Device : ")
        self.device_label.grid(column=0, row=1, padx=5, pady=5, sticky="W", columnspan=2)	
		
        self.connect_button = ttk.Button(self.winfo_toplevel(), text="Connect")
        self.connect_button.grid(column=0, row=2,padx=5, pady=5, sticky="WE", columnspan=4)
		#row3
        self.type_label = ttk.Label(self.winfo_toplevel(), text="Type : ")
        self.type_label.grid(column=0, row=3,padx=5, pady=5, sticky="W")

        self.type_entry = ttk.Entry(self.winfo_toplevel())
        self.type_entry.grid(column=1, row=3,padx=5, pady=5, sticky="E", columnspan=1)

        self.port_label = ttk.Label(self.winfo_toplevel(), text="Port : ")
        self.port_label.grid(column=2, row=3,padx=5, pady=5, sticky="W")

        self.port_entry = ttk.Entry(self.winfo_toplevel())
        self.port_entry.grid(column=3, row=3,padx=5, pady=5, sticky="E", columnspan=1)
		#row4
        self.request_button = ttk.Button(self.winfo_toplevel(),text="Send Request")
        self.request_button.grid(column=0, row=4,padx=5, pady=5, sticky="WE", columnspan=4)
		#row 5
		#see below 
		
		#row6
        self.clear_button = ttk.Button(self.winfo_toplevel(), text="Clear")
        self.clear_button.grid(column=0, row=6,padx=5, pady=5, sticky="WE", columnspan=2)		
		
        self.Uptime_button = ttk.Button(self.winfo_toplevel(), text="Uptime")
        self.Uptime_button.grid(column=2, row=6, padx=5, pady=5, sticky="WE", columnspan=2)
		
        self.return_text = Text(self.winfo_toplevel())
        self.return_text.config(state='disabled')
        self.return_text.grid(column=0, row=5, padx=5, pady=5, sticky="WE", columnspan=4)
        self.return_text.see("end")
        self.clear(controller)

        self.DEBUGMODE = False
        #self.after(2000, self.refresh_debug)#self.printSerialReturn())
		
        def uptime_callback():
            self.UptimeReturn(controller)	
        def send_request_callback():
            self.SendRequest(controller)
        def clear_button_callback():
            self.clear(controller)

        self.clear_button["command"] = clear_button_callback
        self.request_button["command"] = send_request_callback		
        self.Uptime_button["command"] = uptime_callback
		
		
   # def refresh_debug(self):
        #if self.DEBUGMODE == True and self.controller.connection.is_connected():
            #self.printSerialReturn(self.controller)
        #self.after(2000, self.refresh_debug)#self.printSerialReturn())

    def event_connected(self, controller):
        self.statusbar["text"] = "Connection Status: Connected"
        
        self.__set_connected_button(controller)

    def event_disconnected(self, controller):
        self.statusbar["text"] = "Connection Status: Disconnected"
        
        self.__set_disconnected_button(controller)

    def event_disconnected_timeout(self, controller):
        self.statusbar["text"] = "Connection Status: Disconnected (Timeout)"
        
        self.__set_disconnected_button(controller)

    def event_disconnected_error(self, controller):
        self.statusbar["text"] = "Connection Status: Disconnected (Error)"
        
        self.__set_disconnected_button(controller)

    def event_failed_to_connect(self, controller):
        self.statusbar["text"] = "Connection Status: Disconnected (Failed to connect)"
        
        self.__set_disconnected_button(controller)
		
    def re_enable_send_button(self):
        self.statusbar["text"] = "Connection Status: Disconnected (Failed to connect)"
        
        self.__set_disconnected_button(controller)

    def SendRequest(self, controller):
        CommandType = self.type_entry.get()  #String is saved in Command
        CommandPort = self.port_entry.get()

        if not controller.connection.is_connected():
            txt = "Cannot write when not connected"
            self.return_text.config(state='normal')
            self.return_text.insert(END,txt+"\n")
            self.return_text.config(state='disabled')
            self.return_text.see("end")
            return

        # Entry validation:
        if CommandType not in ['0','1','2','X','x', 'U', 'u']:
            txt = "Please enter valid type (0,1,2,X,U)"
            self.return_text.config(state='normal')
            self.return_text.insert(END,txt+"\n")
            self.return_text.config(state='disabled')
            self.return_text.see("end")
            return

        if CommandType == '1':
            if CommandPort not in ['0','1','2']:
                txt = "Please enter valid analogue port number (0,1,2)"
                self.return_text.config(state='normal')
                self.return_text.insert(END,txt+"\n")
                self.return_text.config(state='disabled')
                self.return_text.see("end")
                return

        elif CommandType == '2':
            if CommandPort not in ['0','1','2']:
                txt = "Please enter valid digital port number (0,1,2)"
                self.return_text.config(state='normal')
                self.return_text.insert(END,txt+"\n")
                self.return_text.config(state='disabled')
                self.return_text.see("end")
                return


        elif CommandType in ['x','X']:
            if CommandPort not in ['0','1']:
                txt = "Please enter 0 (debug off) or 1 (debug on) in port field"
                self.return_text.config(state='normal')
                self.return_text.insert(END,txt+"\n")
                self.return_text.config(state='disabled')
                self.return_text.see("end")
                return
            else:
                if CommandPort == '1':
                    self.DEBUGMODE = True
                    self.return_text.config(state='normal')
                    self.return_text.insert(END,'Debug-Mode On'+"\n")
                    self.return_text.config(state='disabled')
                    self.return_text.see("end")
 
                    controller.connection.write(CommandType.encode('utf-8'))
                    controller.connection.write(CommandPort.encode('utf-8'))
                else:
                    self.DEBUGMODE = False
                    self.type_entry.config(state='normal')

                    self.return_text.config(state='normal')
                    self.return_text.insert(END,'Debug-Mode Off'+"\n")
                    self.return_text.config(state='disabled')
                    self.return_text.see("end")

                    controller.connection.write(CommandType.encode('utf-8'))
                    controller.connection.write(CommandPort.encode('utf-8'))
					 
        controller.connection.write(CommandType.encode('utf-8'))
        controller.connection.write(CommandPort.encode('utf-8'))
        controller.connection.write(b"\n")
        #self.printSerialReturn(controller)
        #print("now parsing your request")

    #def printSerialReturn(self, controller):
     #   sleep(0.02)
        #OutputText = self.CleanList(controller.connection.receive())
		
        #print("got input")
        #input_list = controller.connection.receive()
        #for x in input_list:
        #    print(x)

        #if OutputText != '[]':
        #    self.return_text.config(state='normal')
        #    self.return_text.insert(END,OutputText+"\n")
        #    self.return_text.config(state='disabled')
        #    self.return_text.see("end")
		
    def trigger_reset(self, controller):
        if controller.trip_status == "HIGH": 
            CommandType = 'T'
            controller.connection.write(CommandType.encode('utf-8'))
            controller.connection.write(b"\n")

    def writeToScreen(self,str_input):
        self.return_text.config(state='normal')
        self.return_text.insert(END,"["+str_input+"]\n")
        self.return_text.config(state='disabled')
        self.return_text.see("end")        
	
    def CleanList(self,InputList):
        OutputString = "["
        for returnstring in range(0,len(InputList)):
            if (returnstring != (len(InputList) - 1)):
                OutputString += str(InputList[returnstring][:-1]) + ', '
            else:
                OutputString += str(InputList[returnstring][:-1])

        OutputString += "]"
        return OutputString

    def UptimeReturn(self, controller):
        if controller.connection.is_connected():
            controller.connection.write(b"U")
            controller.connection.write(b"\n")
            self.printSerialReturn(controller)
        else:
            txt = "No device has been connected"
            self.return_text.config(state='normal')
            self.return_text.insert(END,txt+"\n")
            self.return_text.config(state='disabled')
            self.return_text.see("end")

    def clear(self, controller):
        if controller.connection.is_connected():
            self.return_text.config(state='normal')
            self.return_text.delete(1.0,END)
            self.return_text.config(state='disabled')
            #self.type_entry.delete(0,'end')
            #self.port_entry.delete(0,'end')
            #self.type_entry.config(state='normal')
            #self.port_entry.config(state='normal')
            #self.request_button.config(state='normal')
        else:
            self.return_text.config(state='normal')
            self.return_text.delete(1.0,END)
            self.return_text.config(state='disabled')
            #self.type_entry.delete(0,'end')
            #self.port_entry.delete(0,'end')
            #self.type_entry.config(state='normal')
            #self.port_entry.config(state='normal')
            #self.request_button.config(state='normal')

            self.device_list = BeetleConnection.possible_connections()

            possible_values = [
                x.device for x in self.device_list if "Arduino" in str(x)
            ]
            self.device_picker["values"] = possible_values
            if len(possible_values) > 0:
                self.device_picker.current(0)
            self.event_disconnected(controller)
   
class DiagnosticFrame(Frame):

    def __init__(self, parent, controller):
        Frame.__init__(self, parent)
		
		#code for adding a submenu to swap frames
		#code for main connection frame)
		#create the menubar
        self.menubar = Menu(controller)
        controller.config(menu=self.menubar)	
	    #create the submenu
        self.subMenu = Menu(self.menubar)
        self.menubar.add_cascade(label="Navigation",menu=self.subMenu)
        self.subMenu.add_command(label="Home", command=lambda: controller.show_home_frame_from_diagnostic_frame())
        self.subMenu.add_command(label="Connection", command=lambda: controller.show_connection_frame_from_diagnostic_frame())
        self.subMenu.add_command(label="Diagnostic")
        self.subMenu.add_command(label="Exit", command= self.winfo_toplevel().destroy)
		
        def about_project():
            tkinter.messagebox.showinfo('About Project', 'This application is a connection and diagnostics viewer and was made by Bradley Fourie for the EDesign344 course at Stellenboch University.')
	
        self.subMenu = Menu(self.menubar)
        self.menubar.add_cascade(label="Help",menu=self.subMenu)
        self.subMenu.add_command(label="About", command= about_project)
		
		#create the page title
        self.page_title_label = ttk.Label(self.winfo_toplevel(), text="System Diagnostics")
        self.page_title_label.grid(column=0, row=0, padx=230, pady=5,sticky="NSEW", columnspan=4)		
        self.page_title_label.config(font=("Calibri", 18))	
		
		
		#graph for the voltage transducer
        self.figure_voltage = Figure(figsize=(6, 2.45), dpi=80)
        self.voltage_graph = self.figure_voltage.add_subplot(1, 1, 1)
        self.voltage_graph.set_title('Voltage Transducer Measurement')
        self.voltage_graph.set_ylabel('Voltage (V)')
        self.voltage_graph.set_xlabel('Time (s)')
		
        self.voltage_graph_line, = self.voltage_graph.plot(controller.time_measurements, controller.voltage_measurements, 'b', marker='o')	
    
        self.voltage_canvas = FigureCanvasTkAgg(self.figure_voltage, controller)
        self.voltage_canvas.draw()		
        self.voltage_canvas.get_tk_widget().grid(column=0, row=1, padx=10, pady=0,sticky="WE", columnspan=4, rowspan=3)
		
		#graph for the current transducer
        self.figure_current = Figure(figsize=(6, 2.45), dpi=80)
        self.current_graph = self.figure_current.add_subplot(1, 1, 1)
        self.current_graph.set_title('Current Transducer Measurement')
        self.current_graph.set_ylabel('Current (mA)')
        self.current_graph.set_xlabel('Time (s)')

        self.current_graph_line, = self.current_graph.plot(controller.time_measurements, controller.current_measurements, 'r', marker='o')

        self.current_canvas = FigureCanvasTkAgg(self.figure_current, controller)
        self.current_canvas.get_tk_widget().grid(column=0, row=4, padx=10, pady=0,sticky="WE", columnspan=4, rowspan=3)

		#graph for the phase transducer
        self.figure_phase = Figure(figsize=(6, 2.45), dpi=80)
        self.phase_graph = self.figure_phase.add_subplot(1, 1, 1)
        self.phase_graph.set_title('Phase Transducer Measurement')
        self.phase_graph.set_ylabel('Degrees (°)')
        self.phase_graph.set_xlabel('Time (s)')

        self.phase_graph_line, = self.phase_graph.plot(controller.time_measurements, controller.phase_measurements, 'g', marker='o')

        self.phase_canvas = FigureCanvasTkAgg(self.figure_phase, controller)
        self.phase_canvas.get_tk_widget().grid(column=0, row=7, padx=10, pady=0,sticky="WE", columnspan=4, rowspan=3)
		
		#create the statusbar
        self.statusbar = Label(self.winfo_toplevel(), text="Trip Status: Not Tripped", relief=SUNKEN)
        self.statusbar.grid(column=0, row=13, padx=5, pady=5, sticky="WES", columnspan=4)
		
 #       def reset_callback():
#            controller.connectframe.trigger_reset(controller)	
			
		#create reset button
#        self.reset_button = ttk.Button(self.winfo_toplevel(), text="Reset Trip Switch")
#        self.reset_button.grid(column=0, row=12, padx=5, pady=5, sticky="WES", columnspan=4)
		
#        self.reset_button["command"] = reset_callback
		
    def updateUI(self,controller):
        if controller.trip_status == "LOW": 
            self.statusbar["text"] = "Trip Status: Not Tripped"
        else:
            self.statusbar["text"] = "Trip Status: Tripped"            
            
        if(controller.runtime >= controller.display_time):
            self.voltage_graph.set_ylim(min(controller.voltage_measurements)-0.1, max(controller.voltage_measurements)+0.1)
            self.voltage_graph.set_xlim(controller.time_measurements[0], controller.time_measurements[len(controller.time_measurements)-1])
			
            self.current_graph.set_ylim(min(controller.current_measurements)-0.1, max(controller.current_measurements)+0.1)
            self.current_graph.set_xlim(controller.time_measurements[0], controller.time_measurements[len(controller.time_measurements)-1])
			
            self.phase_graph.set_ylim(min(controller.phase_measurements)-0.1, max(controller.phase_measurements)+0.1)
            self.phase_graph.set_xlim(controller.time_measurements[0], controller.time_measurements[len(controller.time_measurements)-1])
        else: 
            self.voltage_graph.set_ylim(min(controller.voltage_measurements)-0.1, max(controller.voltage_measurements)+0.1)
            self.voltage_graph.set_xlim(controller.time_measurements[0], controller.time_measurements[len(controller.time_measurements)-1])
			
            self.current_graph.set_ylim(min(controller.current_measurements)-0.1, max(controller.current_measurements)+0.1)
            self.current_graph.set_xlim(controller.time_measurements[0], controller.time_measurements[len(controller.time_measurements)-1])
			
            self.phase_graph.set_ylim(min(controller.phase_measurements)-0.1, max(controller.phase_measurements)+0.1)
            self.phase_graph.set_xlim(controller.time_measurements[0], controller.time_measurements[len(controller.time_measurements)-1])
			
        self.voltage_graph_line.set_data(controller.time_measurements, controller.voltage_measurements)
        self.voltage_canvas.draw()
		
        self.current_graph_line.set_data(controller.time_measurements, controller.current_measurements)
        self.current_canvas.draw()
		
        self.phase_graph_line.set_data(controller.time_measurements, controller.phase_measurements)
        self.phase_canvas.draw()
		
class HomeFrame(Frame):

    def __init__(self, parent, controller):
        Frame.__init__(self, parent)
		
		#code for adding a submenu to swap frames
		#code for main connection frame)
		#create the menubar
        self.menubar = Menu(controller)
        controller.config(menu=self.menubar)	
	    #create the submenu
        self.subMenu = Menu(self.menubar)
        self.menubar.add_cascade(label="Navigation",menu=self.subMenu)
        self.subMenu.add_command(label="Home")
        self.subMenu.add_command(label="Connection", command=lambda: controller.show_connection_frame_from_home_frame())
        self.subMenu.add_command(label="Diagnostic", command=lambda: controller.show_diagnostic_frame_from_home_frame())
        self.subMenu.add_command(label="Exit", command= self.winfo_toplevel().destroy)
	
        def about_project():
            tkinter.messagebox.showinfo('About Project', 'This application is a connection and diagnostics viewer and was made by Bradley Fourie for the EDesign344 course at Stellenboch University.')
	
        self.subMenu = Menu(self.menubar)
        self.menubar.add_cascade(label="Help",menu=self.subMenu)
        self.subMenu.add_command(label="About", command= about_project)
		
		#create the page title
        self.page_title_label = ttk.Label(self.winfo_toplevel(), text="Smart Power Meter")
        self.page_title_label.grid(column=0, row=0, padx=230, pady=5,sticky="NSEW", columnspan=4)		
        self.page_title_label.config(font=("Calibri", 18))	
		
        self.newest_measurements_label = ttk.Label(self.winfo_toplevel(), text="Real Time Measurements")
        self.newest_measurements_label.grid(column=0, row=1, padx=230, pady=20,sticky="NSEW", columnspan=4)		
        self.newest_measurements_label.config(font=("Calibri", 14))
		
        self.newest_voltage_label = ttk.Label(self.winfo_toplevel(), text="Voltage: ")
        self.newest_voltage_label.grid(column=0, row=2, padx=20, pady=5,sticky="W", columnspan=1)	

        self.newest_voltage_entry = ttk.Entry(self.winfo_toplevel())
        self.newest_voltage_entry.grid(column=3, row=2,padx=20, pady=5, sticky="E", columnspan=1)
		
        self.newest_current_label = ttk.Label(self.winfo_toplevel(), text="Current: ")
        self.newest_current_label.grid(column=0, row=3, padx=20, pady=5,sticky="W", columnspan=1)

        self.newest_current_entry = ttk.Entry(self.winfo_toplevel())
        self.newest_current_entry.grid(column=3, row=3,padx=20, pady=5, sticky="E", columnspan=1)		

        self.newest_phase_label = ttk.Label(self.winfo_toplevel(), text="Phase: ")
        self.newest_phase_label.grid(column=0, row=4, padx=20, pady=5,sticky="W", columnspan=1)	

        self.newest_phase_entry = ttk.Entry(self.winfo_toplevel())
        self.newest_phase_entry.grid(column=3, row=4,padx=20, pady=5, sticky="E", columnspan=1)		
		
        self.newest_real_power_label = ttk.Label(self.winfo_toplevel(), text="Real Power: ")
        self.newest_real_power_label.grid(column=0, row=5, padx=20, pady=5,sticky="W", columnspan=1)	

        self.newest_real_power_entry = ttk.Entry(self.winfo_toplevel())
        self.newest_real_power_entry.grid(column=1, row=5,padx=20, pady=5, sticky="E", columnspan=1)	
		
        self.newest_reactive_power_label = ttk.Label(self.winfo_toplevel(), text="Reactive Power: ")
        self.newest_reactive_power_label.grid(column=2, row=5, padx=20, pady=5,sticky="W", columnspan=1)	

        self.newest_reactive_power_entry = ttk.Entry(self.winfo_toplevel())
        self.newest_reactive_power_entry.grid(column=3, row=5,padx=20, pady=5, sticky="E", columnspan=1)	
		
        self.total_power_label = ttk.Label(self.winfo_toplevel(), text="Total Power Usage")
        self.total_power_label.grid(column=0, row=6, padx=250, pady=20,sticky="SEW", columnspan=4)		
        self.total_power_label.config(font=("Calibri", 14))
		
        self.total_real_power_label = ttk.Label(self.winfo_toplevel(), text="Real Power: ")
        self.total_real_power_label.grid(column=0, row=7, padx=20, pady=5,sticky="W", columnspan=1)	

        self.total_real_power_entry = ttk.Entry(self.winfo_toplevel())
        self.total_real_power_entry.grid(column=1, row=7,padx=20, pady=5, sticky="E", columnspan=1)	
		
        self.total_reactive_power_label = ttk.Label(self.winfo_toplevel(), text="Reactive Power: ")
        self.total_reactive_power_label.grid(column=2, row=7, padx=20, pady=5,sticky="W", columnspan=1)	

        self.total_reactive_power_entry = ttk.Entry(self.winfo_toplevel())
        self.total_reactive_power_entry.grid(column=3, row=7,padx=20, pady=5, sticky="E", columnspan=1)	

        self.system_status_label = ttk.Label(self.winfo_toplevel(), text="System Status")
        self.system_status_label.grid(column=0, row=8, padx=270, pady=20,sticky="SEW", columnspan=4)		
        self.system_status_label.config(font=("Calibri", 14))
		
        self.trip_status_label = ttk.Label(self.winfo_toplevel(), text="Trip Switch: ")
        self.trip_status_label.grid(column=0, row=9, padx=20, pady=5,sticky="W", columnspan=1)	

        self.trip_status_entry = ttk.Entry(self.winfo_toplevel())
        self.trip_status_entry.grid(column=3, row=9,padx=20, pady=5, sticky="E", columnspan=1)	
		
        self.connection_status_label = ttk.Label(self.winfo_toplevel(), text="Connection: ")
        self.connection_status_label.grid(column=0, row=10, padx=20, pady=5,sticky="W", columnspan=1)	

        self.connection_status_entry = ttk.Entry(self.winfo_toplevel())
        self.connection_status_entry.grid(column=3, row=10,padx=20, pady=5, sticky="E", columnspan=1)	
        self.connection_status_entry.insert(0, "Disconnected")
		
        def reset_callback():
            controller.connectframe.trigger_reset(controller)
            if controller.trip_status == "HIGH": 		
                self.trip_status_entry.delete(0, tk.END)
                self.trip_status_entry.insert(0, "Not Tripped")
                controller.trip_status == "LOW"
				
		#create reset button
        self.reset_button = ttk.Button(self.winfo_toplevel(), text="Reset Trip Switch")
        self.reset_button.grid(column=0, row=11, padx=20, pady=5, sticky="WES", columnspan=4)
		
        self.reset_button["command"] = reset_callback
		
        self.photo = PhotoImage(file="EELogo.png")
        self.labelImage = Label(self.winfo_toplevel(), image = self.photo)
        self.labelImage.grid(column=0, row=12, padx=20, pady=5, sticky="SEW", columnspan=4)	
		
    def updateUI(self,controller):
        self.trip_status_entry.delete(0, tk.END)
        if controller.trip_status == "LOW": 
            self.trip_status_entry.insert(0, "Not Tripped")
        else:
            self.trip_status_entry.insert(0, "Tripped")   

        newest_voltage = controller.voltage_measurements[len(controller.voltage_measurements)-1]
        newest_current = controller.current_measurements[len(controller.current_measurements)-1]
        newest_phase = controller.phase_measurements[len(controller.phase_measurements)-1] 
		
        newest_voltage = round(newest_voltage,3)
        newest_current = round(newest_current,3)
        newest_phase = round(newest_phase,3) 
        
        self.newest_voltage_entry.delete(0, tk.END)
        self.newest_current_entry.delete(0, tk.END)
        self.newest_phase_entry.delete(0, tk.END)
		
        self.newest_voltage_entry.insert(0, str(newest_voltage) + "V" )         		
        self.newest_current_entry.insert(0, str(newest_current) + "mA" )    
        self.newest_phase_entry.insert(0, str(newest_phase) + "°")
		
        real_power = newest_voltage * newest_current /1000 * math.cos(math.radians(newest_phase))
        reactive_power = newest_voltage * newest_current /1000 * math.sin(math.radians(newest_phase))
		
        self.newest_real_power_entry.delete(0, tk.END)
        self.newest_reactive_power_entry.delete(0, tk.END)
		
        self.newest_real_power_entry.insert(0, str(round(real_power,1)) + "W")         		
        self.newest_reactive_power_entry.insert(0, str(round(reactive_power,1)) + "VAR")
		
        controller.total_real_power += real_power
        controller.total_reactive_power += reactive_power
		
        real_power_wH = controller.total_real_power * controller.runtime / 3600
        reactive_power_varH = controller.total_reactive_power * controller.runtime / 3600
		
        self.total_real_power_entry.delete(0, tk.END)
        self.total_reactive_power_entry.delete(0, tk.END)
		
        self.total_real_power_entry.insert(0, str(round(real_power_wH,1))  + "Wh" )         		
        self.total_reactive_power_entry.insert(0, str(round(reactive_power_varH,1)) + "VARh" )
		
    def event_connected(self, controller):
        self.connection_status_entry.delete(0, tk.END)
        self.connection_status_entry.insert(0, "Connected")

        
    def event_disconnected(self, controller):
        self.connection_status_entry.delete(0, tk.END)
        self.connection_status_entry.insert(0, "Disconnected")

        
    def event_disconnected_timeout(self, controller):
        self.connection_status_entry.delete(0, tk.END)
        self.connection_status_entry.insert(0, "Disconnected (Timeout)")

       
    def event_disconnected_error(self, controller):
        self.connection_status_entry.delete(0, tk.END)
        self.connection_status_entry.insert(0,"Disconnected (Error)")
		
      
    def event_failed_to_connect(self, controller):
        self.connection_status_entry.delete(0, tk.END)
        self.connection_status_entry.insert(0, "Disconnected (Failed to connect)")

		
    def re_enable_send_button(self):
        self.connection_status_entry.delete(0, tk.END)
        self.connection_status_entry.insert(0, "Disconnected (Failed to connect)")
  		
        
class Main:
    def __init__(self):
        app = App()
        app.mainloop()

Main()
