bradfourie/edesign_344/(commit log)

2019-08-09 Uploaded Spice Simulations
    Had to remake all of my schematics at home since they were saved onto a drive in Stellenbosch
2019-08-09 Added Assignment 1 Full Schematic
2019-09-15 Tweaked design by adjusting ripple reducing capacitor
2019-09-22 Final assignment 2 schematic with an reactive load
2019-10-10 Added second screen and fixed navigation
    [gui.py]
2019-10-11 Fixed up UI and added new polling feature
    [gui.py]
2019-10-11 Added polling feature in Arduino code
2019-10-12 Fixed student number and uptime commands
    [Arduino.ino]
2019-10-16 Calibrated ADC output with linear regression
2019-10-16 Fixed up GUI output
    [gui.py]
2019-10-26 Added complete circuit used in report
